prbstr/peak/docs/architecture.md

# Architecture, in full

`CLAUDE.md` has the short version. This file keeps the exact behaviour: thresholds, timings and the order in which the
eyes' reflexes win. Change it when the behaviour changes.

```
Pi (mech)                         Mac (mind)
 servod.py  <-- peak/mech/cmd --  orchestrator  <-- Ollama (brain)
 servod.py  -- peak/mech/sense -> orchestrator
 audiod.sh  -- UDP :5001 PCM ---> senses/hearing.js (whisper) -- peak/mech/event -> orchestrator
 camd.sh    -- UDP :5000 H264 --> senses/vision.js (Ollama vision) -- peak/mech/event ->
 servod.py  -- peak/mech/sense -> senses/presence.js (PIR, distance) -- peak/mech/event ->
 OLED       <-- servod.py draws two eyes (eyes.py, a port of RoboEyes) and moves them by reflex (screen.py)
                                  voice/homepod.py -- AirPlay --> HomePod mini (speaks every {"say"} on peak/+/cmd)
```

- One Mosquitto broker on the Mac (brew service, `*:1883`, anonymous). Bodies are clients only.
- Topics: `peak/<node>/cmd`, `peak/<node>/sense`, `peak/<node>/event`, `peak/<node>/status` (retained online/offline, set by Last Will), `peak/brain/intent`. Schemas in `contracts/`.
- Senses publish **events only**, never raw frames or audio. The orchestrator thinks on events.
- The brain never moves servos or eyes directly. It replies with `{gesture, say}` JSON (enforced with Ollama structured outputs); gestures are named in `node/gestures.yaml`. **With `PEAK_BRAIN_EYES=1` in `mind/.env` the shape is `{gesture, eyes, say}`**, where `eyes` is the name of a trick from `mind/tricks/tricks.yaml` or null. The orchestrator plays the trick after the reply is parsed, on its own time; the reply's own gesture and line win over the trick's, and on a `sensed` event a trick's gesture is dropped. This is **off by default** (5 Nov 2026): the eyes prompt missed the bake-off gate twice by one old case (see the Brain row in Status). Without the switch the prompt and schema are byte for byte what they were before tricks (checked).
- The brain answers in a JSON shape (`{gesture, say}`, or `{gesture, eyes, say}` with the eyes switch; gesture first so it can fire early) enforced with Ollama structured outputs, built in `mind/orchestrator/brain.js`. The models do carry the `tools` capability (an earlier note said otherwise); native tool calling for `look_at` is a follow-up, not a blocker.
- The orchestrator thinks on one event at a time; one more may wait, and a newer event replaces it (latest wins, never a backlog). Bodies that go offline are removed from the hive map.
- `servod` runs one motion at a time with a one-deep queue (newer replaces waiting). `say` runs independently of motion. `{"stop": true}` aborts the current move and releases all servos. On boot it eases servos to rest one at a time (`BOOT_SETTLE_MS`) to avoid inrush.
- `servod` also owns the GPIO sensors listed under `sensors:` in `node/config.yaml` (HC-SR04+ ultrasonic, PIR) and adds `distance_cm`, `motion` and `throttled` to `peak/<node>/sense` every second. `PEAK_SIM=1` simulates the servos only: sensors are real whenever the pins exist, so a body with no PCA9685 wired still senses. Readings go out twice a second and fill the hive map. They are not events: `mind/senses/presence.js` turns them into `{"sensed": "..."}` events on the two moments worth a thought, movement after a quiet minute and something coming close in front (thresholds and the reasons for them are in `presenceFilter.js`). The brain answers a sensed event with one line and no gesture, so no arm swings at something 5 cm away.
- `servod` draws the OLED (`display:` in `node/config.yaml`): two eyes filling the panel, no text and no numbers. `node/eyes.py` is a Python port of FluxGarage RoboEyes (rounded-rectangle eyes with moods, nine positions, blinking, wandering, laughing, confusion, sweat); `node/screen.py` decides what they do from what the body itself knows, with no help from the mind; `node/oled.py` packs the picture and sends only the bytes that changed. One thread in `servod` does all the drawing; the MQTT thread and the sense loop only report what happened and wake it. Like the sensors, the display is real under `PEAK_SIM=1`, and a missing display never stops `servod`.
- Dead-man switch (`node/deadman.py`, 9 Nov): when the mind's retained `peak/mind/mind/status` turns `offline` (its Last Will, sent the moment its socket closes) or the body loses the broker, `servod` cancels the move in progress and the one waiting and the servos hold where they are; it does not release them, because a limp arm drops under gravity. One `[servod] deadman: hold (<why>)` line per hold. An unknown mind status counts as alive, nothing replays when the mind returns, and hand commands still run while it is down. There is no silence timer: the mind's commands are one-shot and one legal move lasts up to 5 s. `servod`'s MQTT keepalive is 5 s (`PEAK_KEEPALIVE_S`), so a silent Wi-Fi drop is noticed within about 10 s. Each queued move carries the number of cancels (stops and holds) made before it; the worker drops one a cancel has overtaken and clears the stop flag under the same lock, so a stop can no longer slip between taking a move and starting it.
- The eyes' reflexes, highest claim first: broker offline or the mind offline = shut (asleep); something coming closer than 30 cm = wide eyes for 1.5 s, once, until it backs off past 36 cm; `look_left` / `look_right` = eyes held to that side for 3 s (the body's left is the viewer's right, position `e`); a spoken line = eyes centred and pulsing in height for 0.07 s per character, starting `talk_delay_s` after the command (2.5 s, the HomePod's lag); strain = tired lids from damage level 2 and one sweat drop more per level, where the level counts undervoltage now, CPU throttled now, undervoltage since boot, and 70 °C or hotter (`0x50005` is level 3: tired, two drops); otherwise they wander and blink. `strain: false` in `config.yaml` switches the strain look off.
- The mind can take the eyes over with an `eyes` command on `peak/<node>/cmd` (`contracts/cmd.schema.json`, `$defs.eyes`): `mood` (default, tired, angry, happy), `look` (center or a compass point, screen terms), `anim` (blink, wink_left, wink_right, confused, laugh; winks name the body's own eyes), `open`, `curious`, `shape`, and `ms` (100-60000, default 4000). A command with any state in it replaces the one before; `anim` alone leaves it in place. When `ms` runs out, or on `{"eyes":{"release":true}}` or `{"stop":true}`, the reflexes have the eyes back, so a mind that dies never leaves them stuck. Asleep and startled still win over the mind. The mood the mind sends replaces the tired look only while it holds; sweat keeps falling. Anything the body does not understand is ignored, never an error.
- **Tricks** are named sequences the hive can play on a body, kept as data on the mind in `mind/tricks/tricks.yaml`: steps of `eyes`, `gesture`, `say` and `wait`, plus a `describe` line for the brain. `mind/orchestrator/tricks.js` checks every trick against the body's command contract and `gestures.yaml` (at most 16 steps and 30 s), and `createTrickPlayer` sends the steps over MQTT; a newer trick or a stop takes the body from the one playing. First set: happy, angry, sleepy, confused, laugh, surprised, wink, peekaboo. A second file, `mind/tricks/learned.yaml`, is merged in at load through the same check (a bad entry is skipped with a warning, a built-in wins a name clash) and `appendTrick()` writes to it: nothing calls that yet. It is the door for teaching by voice and for Lupin.
- **Devices** (7 Nov 2026) are things in the room the hive can switch: nodes on the same broker with no senses and no gestures, the desk light first, a projector and its screen later. Each is data in `mind/devices/devices.yaml`: a `describe` line for the brain, the topic prefix its own firmware uses (`base`), the topic under it whose retained payload says online or offline (`status`, set by the firmware's Last Will), and its `actions`, each with a `describe` line, a topic under the base and the exact payload (a string, or an object sent as JSON). `mind/orchestrator/devices.js` checks the file at load (names are 2 to 24 of `a-z0-9_`, share one namespace with gestures and tricks, topics carry no wildcards, payloads at most 512 characters; a bad entry stops the mind, like a bad built-in trick) and `createDeviceHub` subscribes to the status topics, tracks which devices are online, and publishes an action's payload on its topic. Three things reach it: the brain's `action` field (**with `PEAK_BRAIN_DEVICES=1`** the reply shape gains `action` after `eyes` and before `say`, naming an action or null, with a Devices section, three rules and three examples in the prompt; off by default, like the eyes, until the bake-off says the old groups hold), a trick's `action` step (`tricks.js` checks it against the action names; the player runs it through the hub), and `npm run device -- <action>` by hand. An action is sent whether or not the device is online, with a log line when it is not. The desk light's firmware (lightbar2mqtt, `devices/desk-light/`) takes absolute levels only, so its six actions are presets: on, off, bright (15), dim (3), warm (370 mireds), cool (153).
- `peak-servod.service` reaches the Mac by mDNS name (`twentyones-Mac-mini.local`), not a fixed IP.
