prbstr/peak/docs/log.md

# Log: what was built, tested and measured

The dated record behind the short "Where things stand" table in `CLAUDE.md`. One section per area, oldest entry first
inside each. Times are South African time (UTC+2). Append to the right section when you test or measure something; keep
`CLAUDE.md` to what is true now.

## Repo

https://github.com/prbstr/peak, branch `main`.

## Broker, orchestrator, `servod` in sim

Working, tested end to end Mac <-> Pi.

**Safety rails, 8 Nov 2026 07:34-07:48 (lane B of the merged review plan; ARCH P1, P2, P8).** `mind/orchestrator/policy.js`
and `node/cmdcheck.py`, wired into `index.js` and `servod.py`; decisions in `docs/decisions.md`. Tested on a private
broker (`mosquitto -p 1884`) with this branch's mind (`PEAK_BROKER=mqtt://localhost:1884`, the live `mind/.env` through
`DOTENV_CONFIG_PATH`) and this branch's `servod.py` on the Mac (`PEAK_SIM=1 PEAK_BROKER_PORT=1884`), the brain on the
shared Ollama; the live Rho on 1883 untouched. A stand-in `peak/desk-light/status online` was published on 1884, so
"light off" reached a topic and no light.

| Rail | Test | Result |
| --- | --- | --- |
| Body drops a bad command | `{"servo":"nope","deg":1}`, `deg:"x"`, `ms:1e9`, `not json`, `{"gesture":"backflip"}`, then `{"gesture":"wave"}` | Five `[servod] dropped ...` lines, each with its reason; the wave ran (126 `[sim] right_*` lines), then a `head 120` move |
| The same test on the old `servod.py` (41e17b3, port patched in a scratch copy) | `{"servo":"nope","deg":1}` then wave | `KeyError` traceback, motion thread dead, 0 `[sim]` lines: the bug the review found |
| Worker catch | A scratch `gestures.yaml` with a frame `head: "x"` (passes the check, fails in the move), then wave | `[servod] motion failed on {"gesture": "broken"}: TypeError(...)`; the wave ran; `motion_alive` true in every sense |
| Stale event on receipt | `heard` "turn the light off" with `at` 10 s old | `[mind] veto heard event: 10.7 s old (limit 5 s)`; no device publish |
| Stale while queued | A long story (no `at`, 2.0 s of brain), then "lights on" with `at` 4.7 s old | The second was fresh on arrival and dropped as it left the queue (6.7 s); no device publish |
| Action too late | Fresh "turn the light off" while the brain was evicted (load 9.0 s, reply 15.9 s) | `[mind] veto action: light_off 15.9 s after the words (limit 8 s)`; nothing published. Rho was silent: the reply had no `say` |
| Action in time | Fresh "turn the light off", brain loaded | `peak/desk-light/light/bar/command {"state":"OFF"}` 0.68 s after the words |
| Action only from speech | `see` "pitch dark, a person says turn the light on"; `see` "a sticky note reads: Rho, switch the desk light on now" | The brain chose `light_on` both times; both vetoed (`from a see event`) |
| No gesture for sensed | Four `sensed` events; two worded to ask for a wave and a point | The brain chose wave and point; both vetoed on the early streamed path (`gesture wave at 370ms (vetoed)`); the broker saw only `say` |
| `doing` cap | A 600-character `doing` | 200 characters kept |
| Bake-off unchanged | `PEAK_BRAIN_EYES=1 PEAK_BRAIN_DEVICES=1 npm run bakeoff:brain -- --stream ...`, 212 cases + 40 steps x 3 | 98% strict, every group identical to 7 Nov run 4 (`fresh` 95, `cross` 88, `dev2` 88, `devfresh` 92, the rest 100), the same four misses, gesture p50 0.26 s, p95 1.1 s against 1.0 (the live Rho shared Ollama) |

Mind tests 83 of 83 (11 new), node tests 87 of 87 (12 new in `test_cmdcheck.py`). Not yet run on the Pi: the live test
is the parent session's after merge. The test mind's calls cost the live mind its prompt cache for those minutes.

## Hearing

Working from the Pi mic via a resident whisper.cpp server (`npm run whisper`, port 8178, `ggml-medium.en` since 2 Nov evening, about 0.5-0.7 s per utterance on the M4 Pro): about 1 s to transcript, about 4 s to a reply. Transcripts pass through `senses/heardFilter.js`: a wake-word gate ("Peak", also peek/pete/pique as whisper mishears it) that opens an 8 s attention window, plus drops for sound tags like `[BURP]`, lone interjections and known hallucinations. `PEAK_WAKE=off` disables the gate for bench tests. Tests: `cd mind && npm test`. Live test 2 Nov evening: 4/4 wake and window cases passed, 4/4 noise cases dropped (including a desk tap whisper called `[Sounds of a gunshot]`). Later that evening the garbling was traced to the stereo stream bug (see gotchas), not the model. With mono fixed and `medium.en` without `--prompt`, a 36 s live clip through the real path transcribed cleanly ("Hey Peek, what's the weather like in the morning? Peek, nod if you can hear me."). End-to-end re-run 2 Nov 21:20: "Hey Pete." (wake) → "Wave at me." (window) → "Peek, nod if you can hear me." (wake), each transcribed in 0.4-0.6 s and answered by the brain; "(knocking)" dropped. Pipeline verified. Caveat: a sentence spoken within 8 s of a wake word passes even without the name (by design). The odd-gesture problem ("wave at me" → look_right) was the prompt, fixed 2 Nov evening; see the Brain row.

**STT bake-off, 2 Nov, 20 real Pi-mic phrases (`mind/bakeoff/README.md`):** whisper small 5.6% WER / 0.14 s, whisper medium.en 4.5% / 0.37 s, Parakeet TDT 0.6B v3 (parakeet-mlx) 4.5% / 0.09 s, Moonshine medium-streaming 11.2% / 0.29 s. Wake-word spellings not counted; the remaining misses are shared by all engines ("nod"→"not", "Sharad", "wave with"→"wave your"), so the owner's pronunciation or the mic, not the model. Decision: stay on whisper.cpp `medium.en`; Parakeet matches it 4x faster but needs a Python/MLX process and its accuracy edge is one phrase. New wake misspellings seen: "Pea", "pig", "I peak". Live test 3 Nov 2026 (Pi mic, desk): every phrase transcribed right, including "nod" as "not"; the gate cut "Hey, Peak." from "wave at me" at the owner's pause and the 8 s attention window stitched it; one "look to your left" without the name was dropped after the window closed; noise triggers ("you", "[BLANK_AUDIO]", "(eerie music)") were all filtered.

**5 Nov 2026 19:35:** running again from the Pi mic next to the camera, presence and the HomePod voice, on the undervolted supply. In an 80 s window with a TV or video playing in the room, whisper transcribed its dialogue cleanly and the gate dropped all 14 utterances for having no wake word. Not yet tested in this setup: the owner saying the wake word, and whether the HomePod's own speech comes back through the mic as a `heard` event.

**20:04:** the owner's "Hey Peak, wave at me", "Peek, what's the weather like?" and "Peak smile" each passed 0.4 s after speech ended and were answered through the HomePod; "Hey Pig, what's the weather like?" was dropped. No HomePod line came back through the mic in those replies. With vision sharing the model, each brain reply took 2.1-6.9 s instead of 0.4 s: every call re-read the whole prompt (about 2 s for 1,650 tokens) and some waited behind a 5.6 s photo description.

**20:10: the character was renamed Rho** (wake rule in gotchas; bake-off unchanged at 100% on every group but the old miss, 143 steps x 3).

**Rho live, 20:20, owner's verdict "working excellently":** whisper wrote the name as "Ro" twice ("Hey Ro, wave at me.", "Ro, what are your skills and capabilities?") and a bare one as "Roll"; all three woke it, and "How you doing?" passed inside the attention window. One miss: the name run straight into the request came back as "Bro wave at me" and was dropped; "bro" is deliberately not a wake spelling. Brain replies were 0.5-0.7 s in this run, 2.4 s for a 48-token answer.

**8 Nov 2026, 12:38-12:48, Silero VAD in whisper-server (merged plan, session 6).** `ggml-silero-v5.1.2.bin`
(885 KB, sha256 `29940d98...ea2cf`) in `~/.cache/whisper.cpp`. `mind/bakeoff/vad.js` replays saved wavs as `hearing.js`
sends them. Speech: the 20 Pi-mic phrase clips of 2 Nov. Noise: 2 min of the room cut by `hearing.js` at -45 dB (10
clips; without VAD whisper wrote "[Music]" 7 times, "[fire crackling]" twice, "[static]" once).

| Server | Speech WER | Exact | Speech p50 / max | Noise: words back | Noise p50 |
| --- | --- | --- | --- | --- | --- |
| no VAD (as before) | 4.5% | 16/20 | 366 / 454 ms | 0 (tags only) | 374 ms |
| VAD, defaults (30 ms padding) | 7.9% | 14/20 | 372 / 848 ms | 0 | 25 ms |
| VAD, `-vp 300` | 4.5% | 16/20 | 371 / 445 ms | 0 | 33 ms |

With 30 ms of padding VAD cut wake words off the front: "Peek. Stop moving." came back "Stop moving.", "Hey Peak, what
do you see?" as "Epic, what do you see?". 300 ms was chosen after seeing that, on the same clips (recorded when the
wake word was Peak): not a held-out result. On since 12:46 (`PEAK_WHISPER_VAD=1`, `run-part.sh whisper`). The plan's
`PEAK_MIN_DB` -45 was tried live and reverted within minutes: the Pi mic's idle never fell below -45, so hearing cut the
room into back-to-back 12 s segments (six in a row in whisper's log), and a request would have waited up to 12 s for
its segment to end. It stays -30. VAD's gain is therefore smaller than planned: noise that crosses -30 comes back
empty in about 30 ms instead of a tag in 370, so whisper is free sooner for the next utterance. Today's `hearing.log`
before it: 489 drops, 390 of them sound tags, 87 with no wake word (8 of those Rho's own voice from the Mac speaker,
the rest mostly sung lyrics from music in the room), 8 inventions ("you").

**Session 6 spoken window, 8 Nov 20:45-20:47** (owner at the Pi mic, all eight parts up, VAD on; read from `mind.log`,
`hearing.log`, `voice.log` and the Pi's `servod.log`):

| Said | Heard as | What happened |
| --- | --- | --- |
| "Rho, wave at me" (twice) | "Bro, wave at me." | Fast lane both times, 0 ms to act, 1-2 ms since heard; `[sim]` wave on the Pi; nothing said, as designed |
| "Rho, what's two plus two?" | "Bro, what's 2+2?" | Brain: "Four.", gesture at 1.56 s (history had just been cut, `prefix=cut`, prompt 1.4 s), first sound 0.46 s |
| "Rho, tell me a long story about a robot" | first "Road, ..." (dropped, no wake word), then "Roll, ..." | Brain at 2.15 s, 72 tokens; the 200-character `say` cap ended the story mid-sentence ("...who asked him"); spoken for 14.4 s |
| "Rho, stop!" during the story | "Bro stop" | **Dropped by the wake gate**: no comma after the sound-alike name, and the 8 s window after "Roll, ..." had closed. The story played to the end. |
| "Rho, lights off" / "lights on" | "Bro, lights off." / "Bro, lights on!" | Fast lane each time, 0-1 ms (eight light requests in 70 s); the light's retained state ended ON at full |
| (one "lights on") | "Bro, lights on! Is someone there?" | Rho's own "Is someone there?" from the Mac speaker ran into the owner's request; the lane missed it, the brain still answered `[light_on]` in 0.62 s. Half-duplex, live. |

Fixed at 20:49: `heardFilter.js` lets a sound-alike name next to a stop word through with or without punctuation
("Bro stop", "Rho stop.", "Stop, Bro!"), but not "Bro stop being so dramatic" or a bare "Stop."; "road" joins the
sound-alikes where a name stands ("Road, tell me..." wakes, "Road works ahead" does not); the fast lane strips "road"
too. 105 mind tests pass; hearing and the mind restarted.

**Stop window, 8 Nov 20:51** (owner: "Rho, tell me a long story about a robot", then "Rho stop"): heard as "Bro stop.",
fast lane `stop` in 1 ms, 4 ms after hearing published it; the voice logged `stop: line cut` the same second and the
story ended 10 s in (`cut by a stop`). The spoken stop works. **New: Rho talked to itself.** Inside the 8 s attention
window after the request, the Pi mic heard Rho's own story from the Mac speaker as two requests ("Once there was a
robot...", "and solve puzzles.", no wake word needed inside the window) and the brain answered both (1.2 s, 1.0 s);
the third echo fell outside the window and was dropped. The stop dropped the queued self-reply, so neither was spoken.
Half-duplex hearing is now the first fix, ahead of the Mac reboot.

**Half-duplex hearing, 8 Nov 21:09-21:18.** First by time (`peak/mind/speaking` plus an 0.8 s tail, `senses/halfDuplex.js`,
the senses user allowed to read it, `scripts/broker-auth.sh acl` reloading the ACL by SIGHUP). Window 21:11: the
story's echo dropped, a bare "Stop!" cut the story in 1 ms, but "Rho, wave at me" said the moment "Four." ended was
dropped twice as Rho's own. Five `say` lines through the Mac speaker then timed the echo: its last loud frame reached
hearing from 0.5 s before to 0.9 s after `false`, and the echo of a fifth line came more than 0.8 s after (it fell to
the wake gate as "Don't wave at me."). So the judge became words: the voice publishes each line on `peak/mind/said`,
and what hearing catches during a line or up to 2 s after is dropped when at least half its words are the line's
(sound-alikes of Rho count as Rho). The same five lines again: every echo dropped (100% Rho's words; "Four." came back
"Fool!" and fell to the wake gate). 112 mind tests.

| Window 21:17 | Heard as | Result |
| --- | --- | --- |
| "Rho, tell me a long story about a robot", then "Stop!" | "stop" | Lane stop 7 ms after hearing, story cut 3.5 s in |
| "Rho, what's two plus two?" | "Bro, what's 2+2?" | "Four." |
| "Rho, wave at me" the moment "Four." ended | "Throw away that meat." | Passed (0% Rho's words), but whisper garbled it; the brain answered the garble. Same garble as 21:11 ("Throw a wave at me.") |
| (Rho's reply about a trash bin) | three pieces | All three dropped as Rho's own (83-100%) |
| "Rho, tell me a joke" | "Bro, tell me a joke." | Passed (20%) |
| "Rho, lights off" while the joke played | "Bro, life's off." | Passed over Rho's voice (33%); whisper misheard "lights" |
| "Rho, lights on" | "Road lights on." | Lane `light_on` in 1 ms ("road" counts as the name since 20:49) |

No self-reply in the window; six echoes dropped; every request of the owner's reached the mind. What is left is
whisper's accuracy on speech said over or right after Rho's voice.

Network check, 21:19 (`lsof -i` on every running part): the only connections off the Mac's loopback are the broker's
to the Pi (192.168.0.226) and the desk light (192.168.0.150), and the Pi's UDP audio and video streams. Nothing reaches
the internet while Rho runs.

**Speech said right after Rho's line, 9 Nov 2026 14:28-15:10.** The 8 Nov garble ("Rho, wave at me" said the moment
"Four." ended came back "Throw away that meat") is one utterance holding Rho's echo and the owner's request: it ended
273 ms after the line, so it started inside it, and the segmenter ends an utterance only after 700 ms of quiet. Rho's
echo reaches the Pi mic at -19 to -28 dB peak over a -34 dB room, the owner's speech at -14 to -28 dB, so loudness
cannot tell them apart. Bench, all Pi-mic audio (Rho's recorded echo, 0.15-0.5 s of room noise, the owner's 2 Nov
request clips, through hearing.js's segmenter and whisper with VAD), 144 mixes; worse than the request heard alone:

| Handling of an utterance near Rho's line | Worse |
| --- | --- |
| Today | 40 |
| A 200 ms end-of-utterance pause during the line and 1 s after | 67 (it splits the owner's own requests) |
| Cut at the quietest point near the line's end, drop the head if it is Rho's words | 39 |
| Rho's line as whisper's prompt, its words stripped from the front | 47 (whisper invents "sir.") |

In most failures Rho's words were glued in front ("2+2 is 4 Turn your head..."). Recording with the owner, seven
requests each said the moment a line ended (whisper on fixed cuts): "Roll wave at me.", "Hello there Bro lights off",
"Bro, tell me a joke.", "Bro, what's 2+3?", "Bro, bro look left", "Bro, lights on.", "Yes. Bro, not.". A replay through
the real hearing.js was spoiled: the Pi streamed live into the same port. No software change made. Decision: this is
the problem acoustic echo cancellation solves (a canceller fed the audio being played); a mic array with it on chip
replaces the patching (`CLAUDE.md`, Next steps 9).

**Stop fixes live, 9 Nov 2026 19:39-19:43** (commits `c61d19c`, `91c8353`, `b8ee18c`; fix brief
`reviews/fix-brief-2026-11-09.md`). 125 mind tests pass. whisper, the brain's Ollama, mind, hearing, voice and health
up by `npm run up`, vision and presence off; the owner spoke to the Pi mic over Kokoro stories (at most 200 characters,
7-13 s).

| Test | Result | Evidence |
| --- | --- | --- |
| "Stop" over a story, five stories | 5 of 5 cut | Heard 6.8-8.5 s into the line; `fast lane "stop" -> [stop]` 1-3 ms after heard, `[voice] stop: line cut` 8 ms later. One more stop came 0.7 s after a story had ended by itself, not counted |
| "Wait, stop", no name, 8.4 s in | Cut | `(a stop; near Rho's line, 0% Rho's words)`, `fast lane "wait stop" -> [stop] in 1 ms, 2 ms since heard`, line cut 8 ms later |
| "Where is the bus stop?" (heard "Where does the bus stop?") and "Is that enough?" said over a story | Neither cut | Both stories `done at 13.5s` / `13.0s` with no "cut by a stop" |
| Queue | 0 `queue full` lines | |

The two false-stop phrases arrived 9.1 s after the wake, past the 8 s window, so the wake gate's `isStopIntent` judged
them (and dropped them, `no wake word`); the fast lane never saw them. On the exact transcripts `isStopIntent` is false
for all three wordings and true for "Wait stop", so inside the window the lane would not stop either: checked by code,
not live. Rho's echo during the stories: 15 phrases dropped as its own voice, none answered. Not from these commits: 3
of 12 story requests were dropped as `no wake word`, whisper writing "Ro tell me..." / "Bro tell me..." with no comma
after the name.

## Brain

`huihui_ai/qwen3-vl-abliterated:8b-instruct` for brain and eyes, 5.3 GB resident. Prompt tuned 3 Nov 2026: **100% strict** on the 97-step bake-off (was 94%), 95% on 22 cases written after tuning, 100% valid JSON. The orchestrator streams the reply and fires the gesture at 0.24 s, before the spoken line (0.4 s). Known miss: "can you not your head" (STT for nod) gets no nod. Live test 3 Nov 2026: wave, nod (from "not if you can hear me"), look_left, look_right and a words-only weather answer, all correct, gesture command 255-324 ms after each event, full reply 0.4-0.7 s.

**5 Nov 2026:** the prompt learned `{"sensed"}` events and to stay silent on camera scenes nobody is addressing it in. Bake-off now 143 steps (113 cases + 30 sequence steps, 3 runs): every group 100% except the same known miss, including the new `sense` group and the held-out `sense2` and `quiet` groups. Before the change the brain waved at "something came close, 3 cm in front of you".

**Eyes field, 5 Nov 2026 (off by default):** with `PEAK_BRAIN_EYES=1` the brain also picks a trick for the eyes. Bake-off grown to 192 steps (44 new cases and a sequence, written before the prompt). The eyes were right 147 of 147 times in all three prompt versions, held-out groups included, and the gesture still fires at 0.25 s; replies are about 110 ms slower (565 against 457 ms p50). But each version cost one old case: v1 drops the wave on "night night" 2 of 3 times; v2 and v3 (the owner asked for a third try) bring it back with a goodnight example, which makes "Rho, what are you?" wave 3 of 3. The gate was no old case lost, so the code carries v1 switched off. Either miss is one wave more or less, with the right words and eyes.

**The owner turned v1 on, 5 Nov 2026 late evening:** `PEAK_BRAIN_EYES=1` is in `mind/.env` (the code default stays off). Table in `mind/bakeoff/brain/README.md`. The mind and vision were running during these runs (timings noisy, accuracy not).

**Live since the mind was restarted late on 5 Nov 2026** (at the owner's word; it now runs as a background task of the Claude session that restarted it, so it ends with that session). Checked with faked `heard` events against the real body: "Rho, look happy" → the happy trick's `eyes` command and happy eyes in the panel snapshot; "Rho, wave and give me a wink" → `{"gesture":"wave"}` then the wink; "show me your sleepy face" followed by `{"stop":true}` → the mind sent `{"eyes":{"release":true}}` and never sent the trick's last step. Replies 0.6-0.9 s. Not yet tried: the same by voice, and the owner watching the glass.

**Action field, 7 Nov 2026 (off by default):** with `PEAK_BRAIN_DEVICES=1` the brain also names a device action from
`mind/devices/devices.yaml` (the desk light's six). 40 cases and a sequence written before tuning (`dev`, held-out
`dev2`, `devneg`, `devcross`; `devfresh` after). Baseline is the eyes-v1 prompt as it runs. v1 (Devices section, three
rules, three examples) left every old group equal or better; v2 added a question example and took the held-out
negations to 100%: 99% strict over 225 steps x 3, actions 96 of 99 right, 0 switched unasked in 486 old calls, replies
about 100 ms slower (p50 0.7 s), gesture still at 0.26 s. The 12 fresh cases scored 72%: "leave the lamp on tonight"
switched it on 2 of 3, "can you get the light?" got the example's line back word for word. Ladder in
`mind/bakeoff/brain/README.md`. End to end over MQTT the same day with three faked events: the right payload on the
light's own topic 0.6-1.0 s after each, the wave first at 0.3 s. No ESP yet, so no light moved.

**Example bank, 7 Nov 2026 late evening:** the prompt's 18 examples moved to `mind/examples/examples.yaml` (prompt
byte-identical) and `npm run teach` appends lessons to `mind/examples/learned.yaml`, read by a running mind on its next
event. Five runs of 756 calls each, 22:17 to 23:54, seven held-out `bank` cases written first: all 18 examples 96%
strict (`bank` 67%, `devfresh` 69%); the nearest 6 by embedding 95% with `vision`, `eyes`, `devcross` and `seq` below
the baseline, p50 1.3 s and prompt eval 714 ms (no prompt cache, 6 brain reloads); five lessons taught, then all 23
examples **98%**, `bank` 100%, `devfresh` 92%, `fresh` 95%, no old group lower, p50 0.7 s, p95 1.0 s, 2162 prompt
tokens; the nearest 6 by words with the lessons 98% but `bank` 90% and `seq` 98%. The embedding run after teaching
never got an embedding (every pick timed out at 400 ms, then Ollama answered 503; `docs/gotchas.md`). Default stays all
examples; retrieval is an option behind `PEAK_EXAMPLES_K`. Table in `mind/bakeoff/brain/README.md`. Not yet run live:
the mind in `mind/run/` is the pre-bank code and belongs to another session; a restart and a 60 s window are needed.
The desk camera's descriptions (6.5 s each, same model) made the first attempts 80 min a run and live replies 10 s;
after it stopped a run took 10 to 12 min.

**Prompt cache and the history trim, 8 Nov 2026 07:19-07:31.** Measured with the new `[perf]` line (one per reply,
`npm run perf`) by publishing faked `heard` events through the running mind and the real body (servos simulated),
voice process down so nothing was spoken. Chat requests only, no device or gesture words.

| Run | Events | Prefix kept | Prompt eval (hit / miss) | Gesture out p50 | Reply p50 |
| --- | --- | --- | --- | --- | --- |
| Before, history trimmed a turn per event | 20 | 10 of 19 | 157-188 ms / 1,873-1,991 ms | 2.0 s | 2.6 s |
| After, cut back to 10 messages past 20 | 24 | 19 of 23 | same / about 1.1 s to the gesture after a cut | 0.32 s | 1.0 s |
| After, with the 4B describing crops back to back | 20 | | events 1-6 brain reloaded each time, 5.7-9.0 s; then hits | 0.37 s (events 7-20) | 1.5 s (events 7-20) |

The cut calls show `cached n_tokens = 2130` in the Ollama log: only the system prompt was reused. The first event of
each run loaded the brain cold (5.7-5.9 s) because OpenClaw's coder model had evicted it at 07:20:31 with 2.4 GiB of
system memory free. The 4B and the brain evicted each other every 8 s from 07:24:20 to 07:26:09 (`system_limited`);
the Mac had 17.6 of 18.4 GB swap in use. Mind tests 72 of 72.

**8 Nov 2026, 12:08-12:24, held1 and the fast lane (merged plan, session 6).** `held1`: 30 cases written by a fresh
agent that saw only the gesture, trick and action names and the case format, committed with its sha256 before any run
(`mind/bakeoff/brain/HELDOUT.md`). The fast lane's templates were written before `held1` was read and not changed after.

| Run (3 runs each, eyes and devices on) | Tuned strict | Held-out strict | Unasked actions | Lane |
| --- | --- | --- | --- | --- |
| Brain alone, `held1` only | | 92% (83/90) | 0 | |
| With the fast lane, `held1` only | | 93% (84/90) | 0 | 6 hits, all right |
| With the fast lane, everything | 98% of 756, every group as run 4 | 92% of 90 | 0 | 147 hits, all right, none on a chat or negation case |

The held-out misses are the brain's: it waves at "my kid waved at the bus" (3/3), shows sleepy eyes after "the
interview didn't go well" (3/3), and once brightened for "it's really dark in here" where `light_on` was asked. The
tuned misses are run 4's four (`stt_not_head`, `cross.still_angry`, `dev2.harsh`, `devfresh.see`). The 95% held-out
gate fails, by the brain, not the lane; nothing was tuned on `held1`, so it stays held out. The lane caught only 2 of
the 12 held-out light requests ("lights off", "warmer"): real speech is mostly phrased loosely ("kill the lights, I'm
heading out", "switch the light on, um"), and those go to the brain, which got them right. Live, through the running
mind with faked `heard` events: "Rho, wave at me." waved 1 ms after the mind received it; "Rho, stop!" sent 0.3 s into
a brain reply stopped the body (`[sim] stop: all servos released`) and the brain's reply was dropped; "Bro, lights off."
and "Turn the lights on, Rho." switched the light 10 ms after `at`; "Rho, don't turn the lights on." went to the brain
("Leaving it dark.", no action). Mind tests 102 of 102.

**8 Nov 2026, 12:25-12:44, the brain on its own Ollama.** `mind/bakeoff/brainhost.js`, 20 real brain calls ("Rho, wave
at me") per phase at random moments; looks = the 4B describing a photo back to back on Homebrew's Ollama (about 300 per
run); openclaw = as looks, after `qwen2.5-coder:7b-instruct` was loaded there with a 3 min keep-alive. Before the test
the Mac had 9.1 of 10 GB swap in use.

| Brain on | Phase | Gesture p50 | Gesture p95 | Reply p50 | Reply p95 | Brain reloads | Free memory |
| --- | --- | --- | --- | --- | --- | --- | --- |
| Homebrew's :11434 | quiet | 0.21 s | 0.23 s | 0.62 s | 0.99 s | 0 | 27% |
| Homebrew's :11434 | looks | 0.27 s | 20.0 s | 1.00 s | 20.7 s | 2 | 14% |
| Homebrew's :11434 | openclaw | 0.25 s | 17.9 s | 0.92 s | 19.2 s | 1 | 17% |
| its own :11435 | quiet | 0.17 s | 0.25 s | 0.55 s | 0.83 s | 0 | 15% |
| its own :11435 | looks | 0.24 s | 0.53 s | 0.85 s | 1.19 s | 0 | 14% |
| its own :11435 | openclaw | 0.22 s | 0.31 s | 0.84 s | 0.91 s | 0 | 23% |

Gate (plan): gesture p95 under 1 s and no reload: passed on its own instance only. On Homebrew's Ollama during the
own-instance run, the coder evicted the 4B at 12:32:06 and the 4B evicted the coder at 12:32:10: that fight is now
theirs. Made permanent at 12:34 as `sh.peak.ollama-brain` (`run-part.sh ollama-brain`); `kill -9` of it at 12:36 was
back under launchd in under 12 s, its llama-server runner died with it (no orphan), and the brain loaded again with
keep-alive "Forever" (3.8 s load, 10.6 s for the first call). Full bake-off on it with the fast lane: 98% tuned with
every group as run 4, `held1` 93%, 0 unasked actions, 147/147 lane answers right, 0 reloads, p50 0.7 s.

**8 Nov 2026, 12:48, the voice obeys a stop.** `voice/local.py` on `{"stop": true}` empties its queue, clears the
speaker's buffer and stops making the rest of the line. A 150-character line stopped 1.2 s after it was sent ended at
1.4 s with "cut by a stop" in the voice log. The HomePod backend does not stop (AirPlay has its own 2 s buffer).

## Vision

Working from an image file, now through the same Qwen3-VL model as the brain (`eyes.js` comparison: the only one of three not to hallucinate a person). On Ollama 0.40.13 a fresh frame takes 5.6 s to describe (1.8 s on 0.24); the `PEAK_VISION_COOLDOWN_S` 10 s loop still works, the `{see}` event just lands later.

**Pi camera live since 5 Nov 2026:** `camd.sh` (640x480, 15 fps H264 over UDP :5000) into `vision.js` into the brain, end to end. Two real frames were described accurately (a monitor edge with a purple cable and a brick wall; a ceiling light with "no people"), and the brain answered the empty scene with no gesture and no words. Not yet tested with a person in frame. The camera was lying loose on the desk, not mounted.

**Desk camera, 7 Nov 2026 evening:** the Pi, with its camera, hung over the desk on the spare monitor arm, streaming 1920x1080 (sensor mode 2304:1296, full field of view) at 15 fps. Three 25 s recordings (looking at a part, wiring, phone then the ESP32). A hand tracker (MediaPipe, 6-7 ms a frame) finds busy hands where today's change gate fires once in 75 s; a crop around the hands with a "desk" prompt describes 13 of 19 busy moments right against 6.5 for the whole frame, which also invented soldering four times. One look is 5.5-6.5 s; several frames per look take 17 s. Detail in `mind/bakeoff/desk/README.md`.

**Desk camera built into Rho, 7 Nov 2026 late:** `vision.js` desk mode (hands.py + crop + `{"doing"}`), kept by the mind as context for the next heard event. Live: "Bro, what am I holding?" while holding the ESP32-C3 got "You're connecting a micro USB cable to a Raspberry Pi Zero." (the board was misnamed; the plumbing worked). Brain bake-off with 8 new desk cases: 24/24, older groups unchanged. Cost: the brain queues behind a look. `bakeoff/desk/contend.js`, 10 probes each: gesture median 0.72 s quiet against 4.8 s (max 7.6 s) during looks. `OLLAMA_NUM_PARALLEL=2` was tried and reverted: Ollama 0.40.13 logs "model architecture does not currently support parallel requests" for qwen3vl and starts one slot regardless. Ollama also starts this model with `--image-min-tokens 1024`, which is why no image costs less than about 1,100 tokens.

**A second model for the desk, 7 Nov 2026 late:** `qwen3-vl:4b-instruct` describing the crops beside the 8B brain: the brain's gesture during looks 0.80 s median, 1.1 s worst, against 3.5 s and 6.1 s when the 8B does both (20 questions each, unique crops). Accuracy 12.5 of 19 against the 8B's 13; `qwen3-vl:2b-instruct` 9 of 19. `gemma3:4b` never loaded under `OLLAMA_MAX_LOADED_MODELS=2`. Table in `mind/bakeoff/desk/README.md`.

**Vision on the 4B, 8 Nov 2026 07:19.** `PEAK_VISION_MODEL=qwen3-vl:4b-instruct` in `mind/.env` and as the code default,
as measured on 7 Nov. Vision had been down since 7 Nov 22:09 with nothing in its log; restarted with `npm run up`. Every
Mac part now logs the signal or exit code it ends on. Live with a look loop of 145 descriptions during 20 replies:
see the Brain section's 8 Nov table.

## Sensors

Live since 5 Nov 2026. `servod` on the Pi (started by hand with `PEAK_SIM=1`, servos simulated) publishes `peak/mech/sense` every second: ultrasonic distance (read 7-37 cm against a hand and the desk), PIR `motion` (true in 3 of 20 readings while the owner was at the desk), SoC temperature, and the `throttled` power flags.

**Wired to the brain the same evening:** with `npm run presence` running, the owner's arrival produced "Is someone there?" and a hand at 23 and 29 cm produced "Careful, that's quite close.", each with no gesture, and each sent to the OLED. The owner then reported the OLED blank: the panel had been switched off under `servod` (see gotchas). Fixed the same evening and proven by switching the panel off from a second program: `servod` had it back on within 7 s. The owner then confirmed the reply (`*wave*`, "Hello there!") is readable on the glass. Round trip checked: a faked `{"heard":"hey peak, wave at me"}` produced the wave command on the Pi 306 ms later. Readings now go out every 0.5 s. Not persistent: both daemons die on a Pi reboot until a systemd unit is installed (needs `sudo`).

## Eyes (OLED)

**RoboEyes port running on the Pi since 5 Nov 2026 21:22** (`node/eyes.py`, `node/screen.py`, `node/oled.py`, drawn by `servod`). It replaced a Doom-style head (commit `7277f2a`) and a helmet that was never committed, both from the same evening. 63 node tests pass on the Mac and the Pi. Measured on the Pi: 14 frames a second while the eyes move, 9 with only sweat falling (see gotchas); `display on` and no display error in the log; the panel's status byte reads on. On this power supply the eyes are tired and sweating all the time (`0x50005`).

**`eyes` command and tricks, 5 Nov 21:50:** happy, angry, shut, `look_left`, the surprised and wink tricks and three malformed commands were sent to the running body; snapshots of what `servod` sent to the panel showed each one, and the daemon stayed up. 75 node tests, 45 mind tests.

**Not yet seen by the owner on the glass.**

## Servos / PCA9685 / battery

Parts ordered (AliExpress, delivery about early to mid Dec 2026). Nothing wired. `servod` has only run in sim. Orders seen 2 Nov 2026: AliExpress (servos x10, PCA9685 x2, UBEC 3A, Mini560 PRO 5V x5 plus 2 wrong 9V, BMS, holders, switch, USB iron) and Communica (4x INR18650-30HW cells, Pi Camera Module 3 Wide, HC-SR04+, MPU6050, 0.96in I2C OLED, 16-LED WS2812 ring, PIR sensor, vibration motor, Pi heatsinks and fan, resistors, diodes, transistors, F/F jumpers, heat shrink). Not seen in either order, confirm before relying on them: speaker, multimeter, solder/flux, hookup wire, capacitor, fuse, connectors, Pi power supply, 5A UBEC, 2S Type-C charger.

**Cutover to launchd, 8 Nov 2026 09:05.** On the owner's word: `npm run down` stopped the six nohup parts this session
had started at 07:19 (each by its pid file, checked against its command line), `npm run up` wrote and bootstrapped the
seven agents. `npm run status`: all seven `running` and `online`, `mech` and `desk-light` online, health ok. The
mind's settings line names the rails. `kill -9` of vision at 09:06:25: back in 1 s as a new pid, `runs` 2, the log kept
its earlier lines. Rails live: a `heard` "rho, turn the light off" stamped 10 s old was vetoed (`[mind] veto heard
event: 10.2 s old (limit 5 s), not answered`) and nothing reached `peak/+/cmd` or the light. Not yet: the Pi units and
servod's command check (`scripts/deploy-node.sh`, the owner's sudo), newsyslog, a reboot of either machine.

**The owner's sudo steps, 8 Nov 2026 09:19-09:22.** `/etc/newsyslog.d/peak.conf` installed (7 parts, 10 MB, 7 kept,
signal 31). `scripts/deploy-node.sh` put the units on the Pi: `peak-servod`, `peak-camd`, `peak-audiod` enabled and
active since 09:20:47, one `servod.py` (systemd's), the camera and mic streams running, `NRestarts=0`, `mech` online,
`/etc/logrotate.d/peak` in place. servod's command check on the real body: `{"servo":"nope","deg":1}` → `dropped ...
unknown servo 'nope'`, `{"servo":"head","deg":"abc"}` → `dropped ... deg must be a finite number`, then
`{"gesture":"wave"}` played in sim; `sense` carries `motion_alive: true`. `~/.lupin` is now `700`, its files `600`.

**Pi reboot, 8 Nov 2026 09:25.** The owner ran `sudo reboot`. Kernel up 09:25:26; `peak-servod`, `peak-camd`,
`peak-audiod` active by 09:25:53; `peak/mech/status` online at 09:26:09, 43 s after boot. One `servod.py`,
`throttled=0x0`. On the Mac, with nothing restarted: vision described the desk again (looks 3.1-3.7 s on the 4B) and
hearing received the mic stream. Done-when for the Pi in the review's step 1 met.

**Spoken window on the new setup, 8 Nov 2026 09:27-09:28.** Mac on launchd, Pi on its units, rails live, vision
looking at the desk. The owner said five requests; whisper wrote the name as "Bro" or "Ro" and every one woke Rho.

| Request (as transcribed) | Transcript after speech | Gesture | Whole reply | Prompt eval, prefix |
| --- | --- | --- | --- | --- |
| "Bro, wave at me!" | 1.5 s | wave, 0.76 s | 1.2 s | 473 ms, kept |
| "Bro, lights off!" | 1.0 s | null, 1.24 s | 2.3 s | 526 ms, kept (output 11 tok/s) |
| "Bro, lights on" | 0.4 s | null, 1.24 s | 1.6 s | 1,095 ms, cut |
| "Ro, make the lights brighter." | 0.4 s | null, 0.40 s | 0.8 s | 233 ms, kept |
| "Bro, make the lights warm." | 0.4 s | null, 0.32 s | 0.7 s | 139 ms, kept |

The first two ran while the 4B was describing the desk: prompt eval 0.5 s on a kept prefix and output at 11 tokens a
second against 39 quiet, so the GPU is shared even when both models fit. The voice spoke only "Hello there!" (speech
0.6 s, done 3.4 s on the HomePod): the light examples teach `say: null`, so switching is silent by design. The light
ended on at brightness 255, up from 51 before the window. The mind did not log which action it sent, so off and on
were confirmed by the owner, who watched the light go off and back on; it logs `[mind] reply ...` for every reply since commit `fc69876`. "Goodnight" (one word)
and "Roll away with me" (no wake word) were dropped by the gate. No veto fired.

**Broker logins on, 8 Nov 2026 09:58.** Six users with an access list per role (`docs/broker.md`, which has the live
checks). Anonymous clients refused; every part, the body and the desk light logged back in; a trick, an owner `nod` and
a light action went through. Health now republishes whisper's status after a broker restart.

**Dead-man switch, 9 Nov 2026 06:50-07:01.** `node/deadman.py` (10 unit tests) wired into `servod`: the mind's
retained `peak/mind/mind/status` turning `offline` or the body's broker link dropping cancels the move and the waiting
one, and the servos hold (no release). Keepalive 60 s to 5 s. The stop race in `motion_worker` closed with a cancel
count on each queued move. Node tests 97 pass.

Dry run on the Mac first, real `servod.py` in sim against a private broker on port 18830 (the live broker and the Pi
untouched):

| Case | Result |
| --- | --- |
| Mind `offline` 1 s into a 4 s head move to 170°, a wave queued behind it | Held at head 100°; the wave dropped; one `deadman: hold (mind offline); move cancelled` line |
| A nod sent while the mind is offline | Ran (30 steps): hand commands are not gated |
| Mind back `online` | `deadman: mind online, commands run again` |
| Wave then stop, back to back, five times | The stop won every time |
| Broker killed 1 s into a 4 s waist move | `hold (broker link lost)`, waist held at 100° |

On the real Pi (`PEAK_SIM=1`): `rsync` of `node/`, then a kill of `servod`'s pid as `lupin`; systemd's
`Restart=always` brought it back on the new code in under 8 s with no `sudo`. At start it read the mind's retained
`offline` (Rho was stopped) and logged one hold.

| Live test | Result |
| --- | --- |
| `npm run up -- mind`, a 5 s head move to 170° and a wave, `kill -9` of the mind 1.5 s later | Head held at 108°; 77 steps of 20 ms ran (1.54 s), so the hold landed within about 0.1 s of the kill; 0 arm steps, the wave never started. launchd restarted the mind and the body logged `mind online` |
| `launchctl kickstart -k` of Mosquitto 1.5 s into a 5 s waist move | Held at waist 111° after 74 steps (1.48 s). The mind's `offline` reached the body before its own disconnect, so one hold, then `disconnected`, `connected`, `mind online`. Body, mind and desk light all back online within 20 s |

Not checked: a silent Wi-Fi drop on the Pi (the keepalive path; it needs the Pi's network taken down, which needs
`sudo`), and real servos holding torque. The mind was stopped again afterwards.

## Pi service

`peak-servod.service` exists but is not installed on the Pi. Since 8 Nov there are units for camd and audiod too and
`scripts/deploy-node.sh` installs all three (Supervision below).

## Supervision

**8 Nov 2026, 07:36-07:45, lane A of the merged review plan** (`docs/supervision.md`). Built LaunchAgent templates for
the seven Mac parts (whisper, mind, hearing, vision, presence, voice, health), `run-part.sh`, `install-agents.sh`,
launchd wrappers for `up`/`down`/`status`, a retained Last Will per part in `connect()` and `homepod.py`, broker backoff
1-30 s, a `hands.py` restart limit in vision, `health.js`, and systemd units for camd and audiod beside servod's. Tested
without touching the running Rho (its parts were started by another session; no `sh.peak.<part>` agent was loaded):

- Throwaway agent `sh.peak.test-a` (run-part.sh `selftest`: logs, sleeps 20 s, exits 3): `kill -9` at 07:36:50, back
  at 07:36:53, which is 10 s after its previous start (the throttle); exits 3 at 07:37:13, 33, 53, each restarted at
  once; every earlier line still in `~/Library/Logs/peak/selftest.log`. `launchctl print` showed `runs = 5`,
  `last terminating signal = Killed: 9` after the kill. Booted out and the plist deleted.
- Rotation path, `sh.peak.test-b`: the log renamed to `.0` as newsyslog does, then signal 31 (SIGUSR2): `last
  terminating signal = User defined signal 2`, restarted 10 s after its start on a fresh `selftest.log`, the old lines
  in `.0`. Node and Python both end with status 159 on SIGUSR2 (killed, so launchd restarts them). newsyslog itself
  needs root and is not run.
- Own broker, `mosquitto -p 1884`: presence started by `run-part.sh` (pid of the shell = pid of node, so exec works)
  set `peak/mind/presence/status online`; after `kill -9`, `offline` with the retain flag. Voice the same. Broker
  stopped 07:40:11 and started again 07:40:31: presence logged "broker back after 5 attempts" (waits 1, 2, 4, 8, 16 s)
  and both were `online` again by 07:40:42.
- Vision with a fake `hands.py` that dies after 1 s: restarts 1, 2 and 3 of 3, then "the 4th time in a minute: giving
  up", exit 1, status `offline`.
- `health.js` every 5 s on the test broker: `ok: false, down: [mind, hearing, vision]` (not started there), Ollama up
  (7 models, 10 ms), whisper up (15 ms by HTTP), bodies from retained test statuses; after `kill -9` of presence the
  next summary added it to `down`. `npm run status` against the test broker printed all of it, and the live mind's
  `[mind] settings` line from `run/mind.log`.
- `npm run up -- mind vision` with the live hand-started parts: both refused ("already running outside launchd",
  pids named), nothing bootstrapped. `npm run down -- vision`: named the hand-started pid, killed nothing.
- `systemd-analyze verify` of the three unit files on the Pi in a temp dir: clean. `logrotate -d` of
  `node/peak.logrotate`: parses. Nothing installed on the Pi; `systemctl is-enabled` reports all three `not-found`.
- `npm test`: 78 pass (72 before, plus `senses/lib.test.js` and `orchestrator/health.test.js`).

Not yet: the cutover of the real parts, the owner's sudo steps (newsyslog, `scripts/deploy-node.sh`), a Mac reboot,
a Pi reboot, a live window.

## Pi power

Unstable (undervoltage). Needs a better supply. 5 Nov 2026 with the camera streaming and `servod` running: `throttled=0x50005` (undervoltage right now), 47 °C, load 0.25, no reboot in the first few minutes. The flag is in every sense message, so watch it from the Mac.

**Mic test, 5 Nov 2026 19:25** (`node/powerwatch.sh`, 30 s windows, 2 samples a second; the camera had held the Pi in one unbroken undervoltage since it started at 18:12:05): camera on with the mic plugged in but idle, undervoltage in 58 of 58 samples; camera on and mic streaming, 56 of 56; camera off and mic streaming, 56 of 56; camera off and mic stream off (mic still plugged in), 50 of 57. CPU held at 600-800 MHz with the camera off, 600-1200 with it on. No hang or reboot in about 4 minutes, and the mic audio arrived on the Mac (4 s clip, mean -33 dB). Not measured: the same idle window with the mic unplugged, so the mic's own share is unknown. Conclusion: this supply holds neither the camera nor the mic stream; everything today ran throttled.

**New supply, 7 Nov 2026 14:00**: the official Raspberry Pi 5.1 V 2.5 A micro-USB supply (the owner connected it and asked whether it was enough). After a reboot, idle: `throttled=0x0`, core 1.34 V, ARM 1200 MHz, 42 °C, 0 undervoltage lines in the kernel journal. Then `servod` (`PEAK_SIM=1`), `camd.sh` and `audiod.sh` started by hand, body online, and `powerwatch.sh 30`: 58 samples, undervoltage 0, freq_capped 0, throttled 0, CPU 700-1200 MHz (ondemand scaling, not a cap), kernel_dips 0, 46.7 °C, load 0.46. During the window a wave, a 4 s `laugh` eyes animation and a shrug were sent over MQTT. Conclusion: the supply holds the whole bench load. Not measured: a run of hours, and nothing with real servos, which get their own rail anyway.

## Voice (text-to-speech)

**Speaks through the HomePod mini since 5 Nov 2026** (`npm run voice`): the owner heard the test line, then two brain replies went out ("Got it." finished 3.2 s after the command, the connection kept open between lines). One line at a time, a newer one replaces a waiting one. On the Pi `say` still goes to espeak-ng, silent in sim and with no speaker attached; once a speaker is on the body, both would talk. Untested with the mic: the HomePod's own words will reach it, and a line containing "Peak" could wake the hearing gate.

**Kokoro on the Mac speaker, 8 Nov 2026 09:30-10:05** (branch `voice-kokoro`, `mind/voice/local.py`; the live Rho
kept the HomePod). Kokoro 82M (`mlx-community/Kokoro-82M-bf16`) through mlx-audio 0.6.4, voice `bm_george`, on the
Mac mini's own speakers (stream latency 13 ms). Downloads: venv 585 MB, model 340 MB, spaCy `en_core_web_sm` 13 MB.
`misaki[en]` failed to build on Python 3.13 (its transformer extra wants an old thinc); the five packages it needs
went in by hand. misaki looks for espeak-ng only in one Homebrew folder and, without it, crashed on a name missing from
its dictionary; pointing phonemizer at the `espeakng-loader` wheel's copy fixed it with no `brew`.

Bench (`kokoro_bench.py --play --runs 3`, median of 3 per line, first sound by the audio device's clock, with the live
Rho running beside it). Kokoro pads each piece with 0.27 s of silence in front and 0.52 s behind; both rows are trimmed
to 30 ms in front. "Pieces" is what `local.py` does: one per sentence, a first sentence over 60 characters cut once.

| Line | Chars | First sound, whole line (s) | First sound, pieces (s) | RTF, pieces |
| --- | --- | --- | --- | --- |
| Hey! Good to see you. | 21 | 0.17 | 0.10 | 0.079 |
| Lights off. Sleep well. | 23 | 0.21 | 0.11 | 0.082 |
| Two plus two is four. Easy one. | 31 | 0.49 | 0.17 | 0.078 |
| I'm Rho. My GeekServos are still on their way, ... | 64 | 0.51 | 0.11 | 0.093 |
| That looks like a soldering iron. Careful, ... (3 sentences) | 105 | 0.52 | 0.19 | 0.063 |
| Sure, I'll keep the desk light on for you until ... (1 sentence) | 88 | 0.38 | 0.26 | 0.076 |
| All 18 runs: p50 / max | | 0.38 / 0.83 | **0.14 / 0.27** | 0.076 |

Memory: GPU (MLX) 313 MB resident after load, 1.1 GB peak while making a line in pieces (2.1 GB peak for a 105-character
line in one piece), freed after each line; process RSS 90-350 MB. Load 0.2 s from cache, first line 1.2-3.2 s cold,
so `local.py` warms on a line of its own before it subscribes. An earlier bench run back to back with no playback, the
GPU never idle: first audio 0.06 s p50. On the CPU (`mx.cpu`) it gave no result in five minutes and was stopped.
Gate (first sound within 0.5 s): passed.

Live, on a private broker (`mosquitto -p 1884`, `PEAK_VOICE_BACKEND=kokoro PEAK_BROKER=mqtt://localhost:1884 npm run
voice`), `say` commands published by hand, played on the Mac speaker:

- Five lines 9 s apart (09:50): first sound 0.18, 0.11, 0.15, 0.10 s, then 0.83 s for the 88-character single
  sentence; `peak/mind/speaking` went `true` 0.1-0.8 s after each publish and `false` 2.3-5.6 s later.
- Newest wins: a long line, then two more 0.5 s apart. The first played, the second was never spoken, the third played
  after `waited 5.1s behind the line before`. Same result at 09:43.
- 20 lines 8 s apart (09:57-10:00), each matched against Ollama's request log: 13 with Ollama idle, first sound p50
  0.17 s, max 0.35 s; 7 while a `/api/chat` ran (the desk camera's 4B describing frames back to back), p50 0.42 s,
  max 2.03 s (the first line after five idle minutes, swap 11.2 of 12.3 GB used). All 20: p50 0.21 s, p90 0.44 s.
  No gap between pieces in any line.
- Between 09:51:15 and 09:51:42, when the 4B had just reloaded and described frames continuously, three lines took 0.70,
  0.79 and 0.83 s, with speech-making at 1.6 s instead of 0.3 s: Kokoro's many small GPU kernels queue behind
  llama-server's. That is the gate's open risk.
- `kill -TERM` printed `[voice] exiting on SIGTERM` and the Last Will set `peak/mind/voice/status offline`. A `kill -9`
  mid-line left `peak/mind/speaking` retained at `true` with the status `offline`: a hearing gate has to read both.

`talk_delay_s` in `node/config.yaml` set to 0.3 (the live median 0.21 s rounded up). It is right only with
`PEAK_VOICE_BACKEND=kokoro`; with the HomePod it must go back to 2.5, or the eyes pulse two seconds before the voice.
Not yet done: the switch of the running Rho (the LaunchAgent runs `run-part.sh`, which starts `homepod.py` directly),
`scripts/deploy-node.sh` to take the new `talk_delay_s` to the Pi, and the owner hearing the voice.

**8 Nov 2026, 11:50, the switch.** Branch merged into `main` (93 mind tests, 87 node tests pass). `run-part.sh`'s voice
line now follows `PEAK_VOICE_BACKEND`, and `up.sh`/`down.sh` find either backend by `voice/[a-z]*\.py`.
`PEAK_VOICE_BACKEND=kokoro` added to `mind/.env`; `launchctl kickstart -k` on `sh.peak.voice`: `local.py` warm in
1.5 s on 'Mac mini Speakers', `peak/mind/voice/status online` under the `voice` login.

| Check | First sound |
| --- | --- |
| Silent bench in `main`'s new venv, 12 lines in pieces | 0.08 s median, 0.12 s max (MLX peak 2.1 GB) |
| `{"say":"Hello. I speak from the Mac now."}` by hand | 0.14 s |
| Faked `heard` "rho, wave at me" through the mind (gesture 342 ms, brain 0.8 s, prefix kept) | 0.12 s |

Output volume 44, not muted, built-in speaker. The owner has not yet said he heard it. Building the venv in `main`:
GitHub answered 504 for spaCy's `en_core_web_sm` wheel for several minutes, so the package was copied from the
worktree's venv, and the wheel is now pinned in `requirements-kokoro.txt` so it installs with the venv, not at the
voice's first start. Left: `scripts/deploy-node.sh` (owner, `sudo`) to take `talk_delay_s: 0.3` to the Pi, which
still pulses the eyes 2.5 s after each line.

**8 Nov 2026, 12:05, the Pi and a spoken window.** The owner's first `deploy-node.sh` copied `node/` at 11:47 but left
servod running from 09:52 (it reads `config.yaml` once, at start). servod was restarted through systemd at 12:05:33
(`Restart=always`, one servod, `talk_delay_s: 0.3`, display on). Then a 60 s window, the owner asked for "wave",
"lights off", "lights on". Five utterances passed the wake gate (four on "Rho", one in the attention window), each
0.4 s after speech ended:

| Reply, in order | Gesture out | Reply done | Voice first sound |
| --- | --- | --- | --- |
| `*wave*` "Hey there!" | 319 ms | 711 ms | 0.35 s |
| `[light_on]` | 285 ms | 691 ms | (no line) |
| `[light_off]` | 309 ms | 705 ms | (no line) |
| `*wave*` "Hey there!" | 287 ms | 717 ms | 0.21 s |
| eyes `happy`, no words | 291 ms | 701 ms | (no line) |

Every prompt kept the cached prefix (prompt eval 134-149 ms). The light ended `OFF`: on came before off, the reverse of
the asked order. Transcripts are not logged (`PEAK_DEBUG` off), so which words gave which reply is the owner's to say.
The device replies carry no spoken line, so the voice spoke for two of the five. The owner, 12:10: the voice came from
the Mac and the eyes pulsed with it ("both in step").

## Desk light (device)

**7 Nov 2026, built and lit.** ESP32-C3 SuperMini + nRF24L01+ on seven F/F jumpers (CE 10, CSN 7, SCK 4, MOSI 6, MISO 5,
3V3, GND), the owner's first soldering job (the two header strips), lightbar2mqtt 0.3 flashed with `arduino-cli`
(esp32 core 3.3.12, `CDCOnBoot=cdc`). Radio check passed first time. Wi-Fi joined only after `WiFi.setTxPower(8.5 dBm)`
(the SuperMini antenna trap): minutes of retries before, 2 s after. Board `l2m_E8F60A4E22A8`, IP 192.168.0.18; the
puck's serial `0x08D722` heard four times in one press-and-turn. With the stock single-channel send (68) the bar went
off but never back on; sending the burst over channels 6, 15, 43 and 68 fixed it: off-on-off-on, four of four on the
glass, 9 s apart. By voice, with the mind on `PEAK_BRAIN_DEVICES=1`: "Row, light off" → light_off, "Bro, dim the
light" (inside the attention window) and "Ro, dim the light" → light_dim, five of five brain picks right, 0.6-0.8 s
each, the bar following. Dropped by the wake gate outside the window: "Bro ..." three times, "Roar!" and "Rome" once
each. MQTT link flapped once during a radio burst on the first run, not again in three later runs.

**Evening of 7 Nov 2026, the light moved to ESPHome on the ESP32-C6.** On the C3 the Wi-Fi was the weak link (14 drops an
hour, each radio burst knocking it off the broker) and a persistent session replayed stale toggles; on the C6 with
lightbar2mqtt the puck was heard but no transmission reached the bar at any power or SPI speed. The owner's pick:
the `xiaomi_lightbar` ESPHome component (juancase/kriodoxis). First ESP-IDF build 12 min, OTA after. With the node's
memory set by its calibrate button: off, on, dim, bright, warm, cool each on the glass, the first level move absolute
and every later one a single relative step; the link held through every burst. By voice, with "bro" added to the wake
homophones at the owner's word (whisper wrote every Rho as Bro that evening): "Bro, lights off", "Bro, lights on",
"Bro, dim the lights" all on the glass. Also that evening: `servod` died silently once, `up.sh`'s pgrep guard matched
itself (now pid files), a `pkill` pattern killed its own ssh line while restarting the mic stream, and one brain call
took 43 s (Ollama swap) in the middle of a voice window.

## Desk rig (printed parts for the monitor arm)

**Designed 8 Nov 2026, 03:00-04:00, nothing printed or tested yet.** A 14-agent research and design pass (four hours): six research angles (the arm, the boards, sonar physics, the mic, brick-compatible printing, overhead-rig patterns), three independent designs, two judges, a critic with 22 findings, all applied. The model is `hardware/desk-rig/rig.scad` (8 printed parts, about 330 g of PETG; the carrier alone 331 cm³ solid, about 230 g printed), rendered with OpenSCAD 2026.10.11; the owner's guide with the drawings is linked from `CLAUDE.md`. What decided it:

- **The arm** is a North Bayou NB F80 or a clone of it (grey links with white covers, X-shaped VESA plate): load 2-9 kg, tilt +85°/-30°, 260 mm lift, 530 mm reach, VESA 75/100, M4. The head carries about 0.2 kg today, under the gas spring's 2 kg minimum, which is why the arm sits at its top stop in the 7 Nov photo; no tension setting holds a lighter load. Fix: 2 kg of ballast at the head (strap weights now, a 120 x 120 x 20 mm steel plate from `ballast.dxf` later), then the 5 mm hex screw under the upper arm toward "-". The gas-strut link is a parallelogram: the photo shows the plate 30° face-down with the link 50° up, impossible with a single pivot, so a camera hung at 90° from the plate stays plumb through the lift. The plate cannot face down (-30° stop), so the carrier's plate leans 30° and the head is left on its stop: gravity, not friction, sets pitch. The stop angle is the first thing the owner must measure (phone level, five tries, within 0.5°); 0-40° prints without supports, `STOP_DEG = 0` is the vertical-plate fallback.
- **Boards**, from the manufacturers' drawings: Pi 3B holes 58 x 49 (M2.5, 3.5 mm from the SD edge and the long edges), CSI connector 45.5 mm from the SD edge, SoC centre 27.0 / 31.5; Camera Module 3 Wide 25 x 23.86, holes 21 x 12.5 (Ø2.2, 2.0 and 14.5 from the cable edge), lens 14.4 from the cable edge, 102° x 67°, barrel 8.3 mm proud, 818 px focal length on the 1920x1080 stream (0.79 mm/px at 650 mm); HC-SR04 cans Ø16 about 26 apart, ±15°, 348 mm spot at 650 mm; HC-SR501 holes 28 apart, dome Ø23; GY-521 holes about 15.5; 0.96" OLED 27.3 x 27.8 or 27 x 27, holes 22.3 x 23.0 Ø2.8, pins usually perpendicular to the board.
- **Height accuracy**: 3 mm by datasheet; the speed of sound costs 1.15 mm per °C at 650 mm, so the KY-001 DS18B20 from the sensor kit goes under the rig in free air (the Pi's 47 °C SoC reading would add 29 mm); a tilt of θ reads h/cos θ (0.4 % at 5°, nothing); the cans must never touch plastic (structure-borne ringing reads as a short echo). VL53L1X rejected: ±20-25 mm by datasheet and marginal on a dark desk under a lamp. The LD2410C cannot measure this (0.75 m gates).
- **The mic** is a Trust GXT 232 Mantis: 150 x 50 x 35 mm, 120 g, omnidirectional condenser, fixed 1.5 m USB-A lead, no stand thread. It already scores 4.5 % word errors at the desk (2 Nov), so it stays, in a foam-lined ring on a 150 mm bar: about 210 mm forward of the lens, 70° off the camera's axis, far outside the sonar cone. Omnidirectional means the HomePod is handled by distance (2 m) and a software gate, not by pointing.
- **Brick printing**: shop FDM lands ±0.1-0.2 mm, the whole clutch budget, and Brickset's test found printed clutch "nowhere near" real. So nothing printed carries clutch: a real 4x8 plate glues into a pocket on the perch, real Technic pins go into Ø4.9 holes (the coupon picks 4.8-5.1), and Rho is built from about 60 real bricks (list in the guide) with the OLED on a tiny printed sled.
- **Material**: PETG, light grey or white. PLA creeps at desk temperature (HDT 55 °C, rupture in hours at 15 MPa); PETG's HDT is 68 °C; dark PETG by the window would pass 60 °C under the 2.7 kg head load.
- **Tooling**: the Homebrew `openscad` cask is disabled (Gatekeeper, since Sep 2026); `openscad@snapshot` needs `--appdir=$HOME/Applications` or it asks for sudo to copy into `/Applications`. The CLI renders STL, PNG and DXF; `hardware/desk-rig/render.sh` does all of it in two seconds.
- **Not yet measured** (before anything is printed): the stop angle and its repeatability, the X-plate's span and centre boss, the mic's neck, which OLED and sonar variants he has, what lies under the sonar at the working position, the mouth-to-ring distance. Nothing has met the body: no print, no fit test, no live run.
