prbstr/peak/docs/environment.md

# Environment facts, in full

`CLAUDE.md` has what a new chat needs. This file keeps the rest: versions, dates, what was checked and when. Facts
here were true on the date they carry; check before relying on one.

- Mac: Mac mini, 24 GB unified memory. Mac IP on the LAN is `192.168.0.139` (interface `en1`, not `en0`; `ipconfig getifaddr en1`).
- Pi: `lupin@mech.local` (192.168.0.226 at last check), key login works, **`sudo` needs a password** so Claude cannot install packages. Ask the owner to run `sudo` lines.
- Attached to the Pi on 5 Nov 2026 (Communica order, wired per the Claude Doc "peak — Bench wiring guide", https://claude.ai/artifact/VFhBowXNv9TeSvXViN2TWc, tab "Connect now"): Camera Module 3 Wide (`imx708_wide`), OLED at I2C `0x3c`, HC-SR04+ on GPIO23 trig / GPIO24 echo (3.3 V), PIR on GPIO17. The owner bench-tested all of these plus the MPU6050 (`0x68`) on 5 Nov; all passed. The MPU6050 takes turns with the OLED on the same four pins until a breadboard arrives, and the OLED was the one connected at 18:00. No USB mic was plugged in at that check. The venv was rebuilt with `--system-site-packages` (gpiozero, lgpio from apt; luma.oled, smbus2, Adafruit PCA9685 from pip; **not** `adafruit-circuitpython-neopixel-spi`). `i2cdetect` is `/usr/sbin/i2cdetect` over non-login ssh.
- Pi header, physical pins, as wired with F/F jumpers: OLED or MPU6050 on 1 (3.3 V), 9 (GND), 3 (SDA), 5 (SCL); PIR on 2 (5 V), 6 (GND), 11 (OUT); HC-SR04+ on 17 (3.3 V), 20 (GND), 16 (Trig), 18 (Echo). Planned once a breadboard, M/F jumpers and a soldering iron are here (GPIO numbers stay the same): fan on 4 and 14, vibrator motor through a BC337 from pin 13 (GPIO27), NeoPixel DIN on pin 19 (GPIO10, SPI). The NeoPixel needs SPI enabled, `core_freq=250` in `/boot/firmware/config.txt` and the neopixel-spi package; none of the three is in place (checked 5 Nov), and the first two need `sudo`. PCA9685 servo power (V+) comes from the 5 V buck, never the Pi.
- A second handover is kept in the owner's claude.ai Project (also named "lupin") and is not on disk; the owner pastes it in. Its 5 Nov 18:05 copy was well behind this repo (it still described a Claude-API mind, no commits and the hostname `slav`). Checked against the Pi that evening: hostname, key-only ssh, I2C, watchdog (10 s), `mosquitto-clients` and the venv are all done. This file is the one to trust; take hardware news and the owner's plans from the pasted one.
- HomePod mini: AirPlay name **Bedroom**, `192.168.0.191`, tvOS 27.2, model `AudioAccessory5,1`, AirPlay open to the network (no pairing needed), volume 33 on 5 Nov 2026. It was the only AirPlay speaker `dns-sd -B _raop._tcp` found; the first-gen HomePod did not show up.
- Ollama: Homebrew service, **0.40.13** since 3 Nov 2026 (was 0.24.0; `brew upgrade ollama` kept the plist below intact, then `launchctl bootout/bootstrap` to reload). 0.40 runs Qwen3-VL on llama-server, not Ollama's own engine: brain 0.4 s and 5.3 GB (was 0.5 s, 7 GB) but a fresh photo takes 5.6 s instead of 1.8 s, and the scheduler evicts on free *system* RAM too. Downgrading to 0.24.0 means `brew extract` of the old formula (no bottle cached). Config in `~/Library/LaunchAgents/sh.brew.ollama.plist` (flash attention, q8 KV cache, `OLLAMA_MAX_LOADED_MODELS=2`, `OLLAMA_KEEP_ALIVE=30m`). Reload with `launchctl bootout/bootstrap`, not `brew services restart` (it rewrites the plist). Live log: `/opt/homebrew/var/log/ollama.log` (`~/.ollama/logs/server.log` is stale). The GPU gets about 17.8 GB of the 24 GB. Another program also loads `qwen3:14b` (12 GB at 32K ctx) or `qwen2.5-coder:7b` into Ollama at times; do not stop it, but expect it to evict our models when the total passes the budget.
- The shell tool cannot write to `/tmp` for ffmpeg outputs reliably; use `mktemp -d` dirs.
- Ollama models (cleanup 4 Nov 2026, freed about 66 GB): peak keeps only `huihui_ai/qwen3-vl-abliterated:8b-instruct` (brain and eyes) and `huihui_ai/qwen3.5-abliterated:9b` (accuracy option, kept for fun). Removed: both Gemma 4 12B, `qwen3-abliterated:8b`, `richardyoung/qwen3-14b-abliterated`, `qwen2.5vl:3b`, `moondream`; re-pull to rerun old bake-offs. Everything else belongs to OpenClaw (`~/.openclaw/openclaw.json` and `agents/main/agent/models.json`: `qwen3:14b`, `qwen2.5-coder:7b-instruct`, `nomic-embed-text`, `llama3.1:8b`); do not remove those. `qwen3-coder:30b` and `gemma4:26b` were removed at the owner's request (4 Nov 2026, 35 GB) and taken out of `models.json` too (backup: `models.json.bak-20261104`). Lupin uses no Ollama models. Code fallbacks for `PEAK_MODEL` and `PEAK_VISION_MODEL` now name Qwen3-VL.
- Whisper: whisper.cpp `whisper-server` on 127.0.0.1:8178, `ggml-medium.en.bin` (and `ggml-small.bin`) in `~/.cache/whisper.cpp`. The old openai-whisper CLI (`~/.cache/whisper`) is still installed but unused.
- STT bake-off harness in `mind/bakeoff/` (own venv at `mind/bakeoff/.venv`, python3.13: moonshine-voice, parakeet-mlx, jiwer). Models cached by Moonshine and Hugging Face on first run.
