prbstr/peak/desk-camera-mockup.jpg

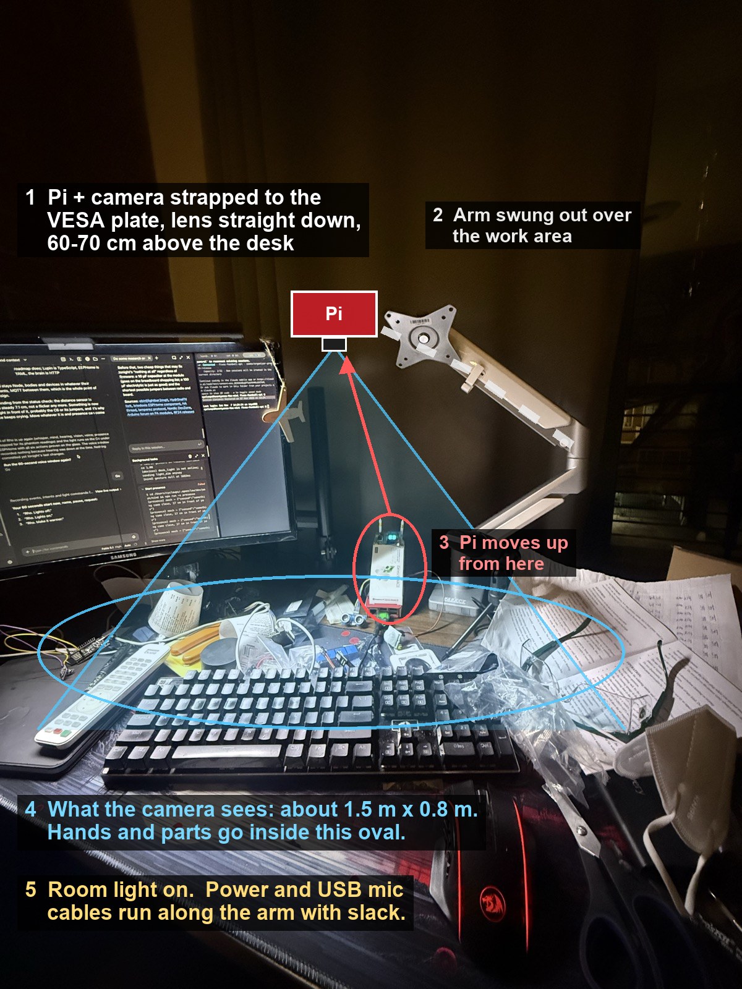
desk-camera-mockup.jpg
