prbstr/peak/hardware/desk-rig/png/ballast.png

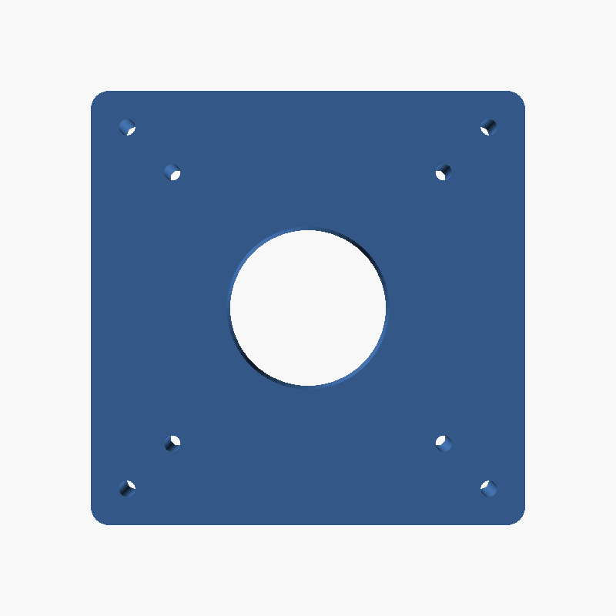
hardware/desk-rig/png/ballast.png
