prbstr/peak/hardware/desk-rig/png/carrier.png

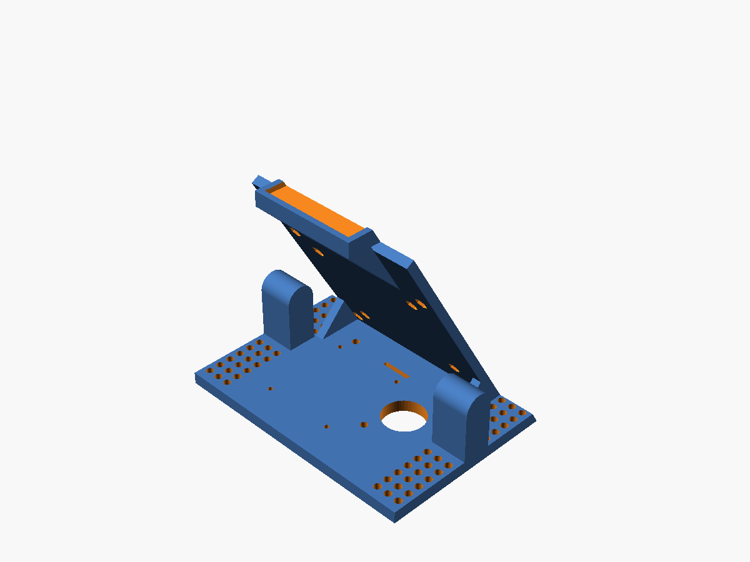
hardware/desk-rig/png/carrier.png
