prbstr/peak/hardware/desk-rig/png/coupon.png

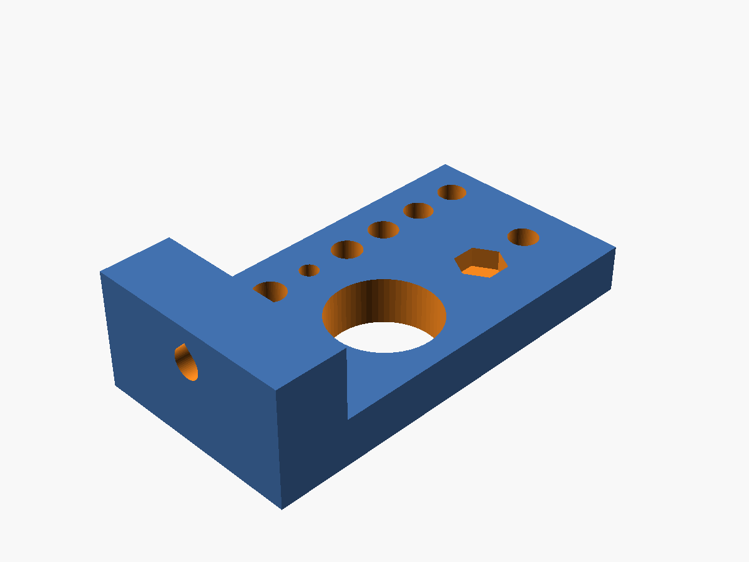
hardware/desk-rig/png/coupon.png
