prbstr/peak/hardware/desk-rig/png/micbar.png

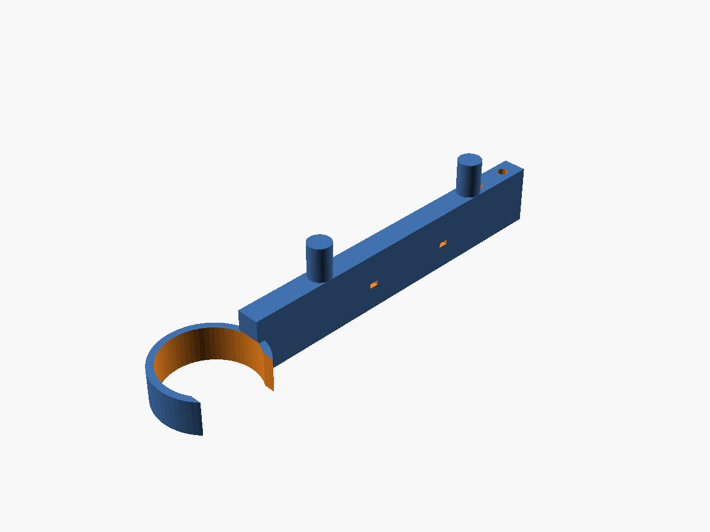
hardware/desk-rig/png/micbar.png
