prbstr/peak/hardware/desk-rig/png/outrigger.png

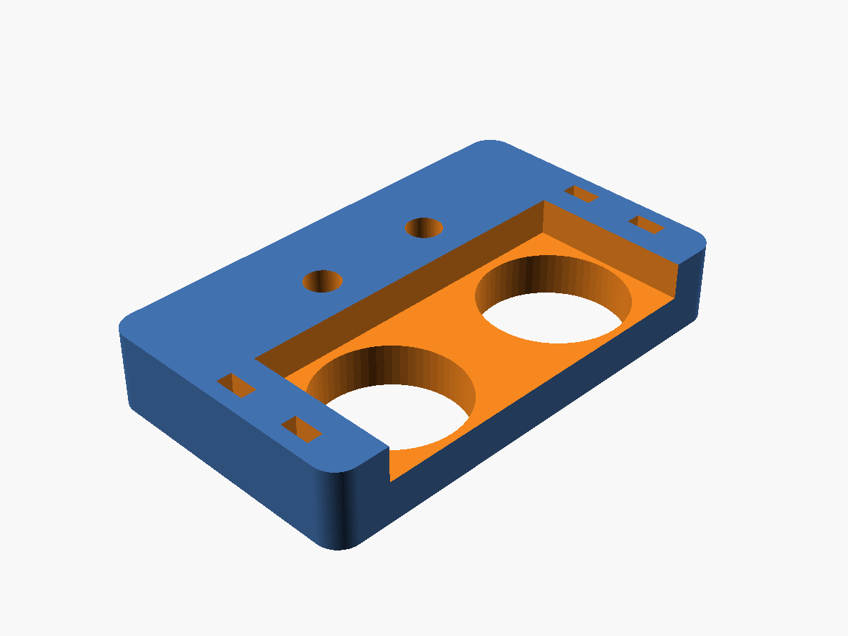
hardware/desk-rig/png/outrigger.png
