prbstr/peak/hardware/desk-rig/png/pirwedge.png

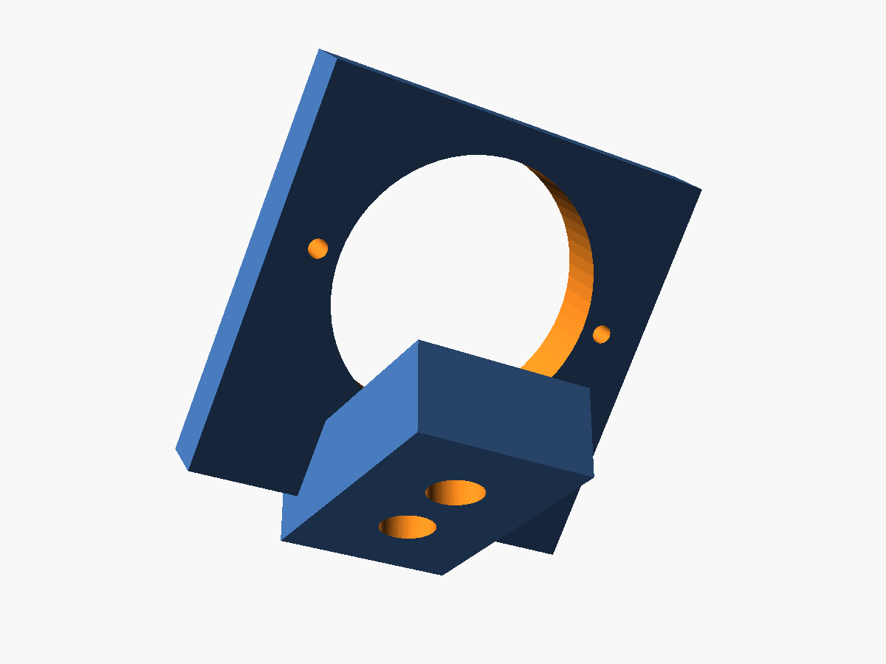
hardware/desk-rig/png/pirwedge.png
