prbstr/peak/hardware/desk-rig/png/pod.png

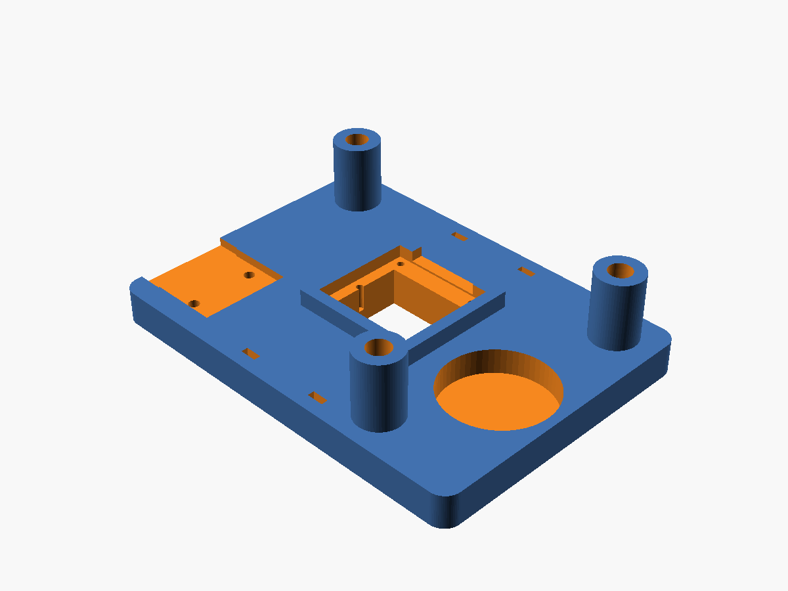
hardware/desk-rig/png/pod.png
