prbstr/peak/hardware/desk-rig/png/shims.png

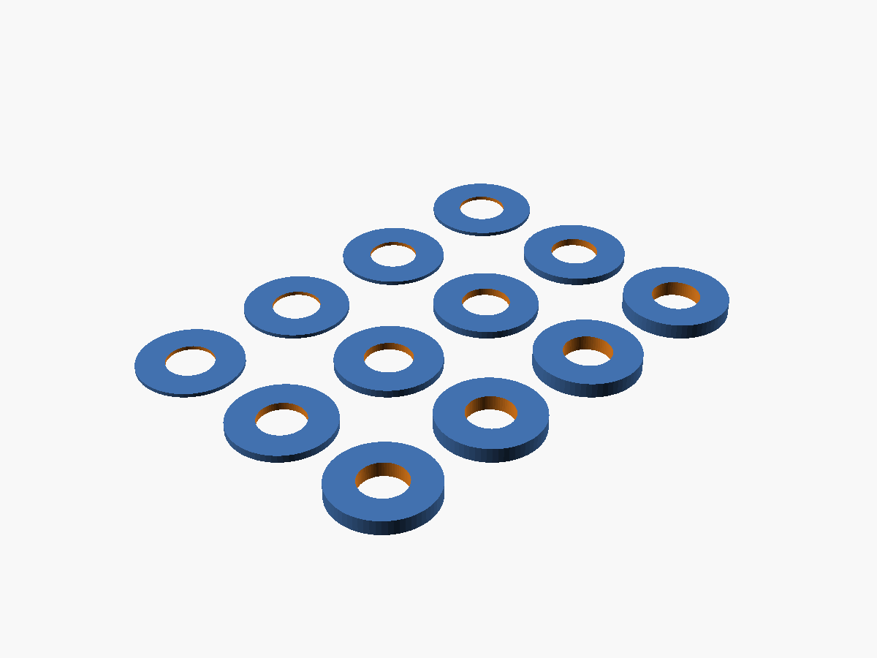
hardware/desk-rig/png/shims.png
