prbstr/peak/hardware/desk-rig/png/sled.png

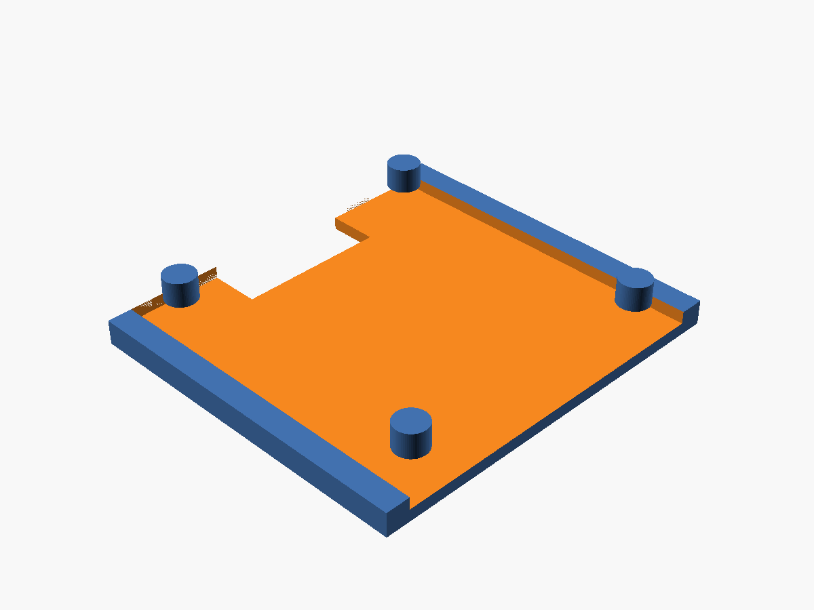
hardware/desk-rig/png/sled.png
