prbstr/peak/shopping/cart-desk-light.md

# Cart brief: desk light hack

For a browser agent (Claude in Chrome, ChatGPT Atlas, etc.). Fill the cart only.

## Rules
- Do NOT check out, pay, enter card details, or change account/address settings. Stop at the cart page and report.
- Prefer one store for everything (shipping). Order of preference: Communica, Micro Robotics, DIY Electronics.
- If an item is out of stock, try the next store, then report. Don't substitute anything outside "acceptable".
- Don't add extras, warranties or insurance.

## Items
| # | Item | Qty | Search for | Acceptable | Not acceptable | Max price each |
|---|---|-----|---|---|---|---|
| 1 | ESP32 dev board | 1 | "ESP32 WROOM-32 dev board" | ESP32-WROOM-32 or DevKitC, USB on board, pin headers fitted | ESP32-CAM, ESP8266, ESP32-C3/S2 boards, bare modules | R180 |
| 2 | nRF24L01+ module | 1 | "nRF24L01+ transceiver module" | nRF24L01+ with PCB antenna, 8-pin 2x4 header | PA+LNA version with an external antenna, SMD "mini" version (1.27 mm pitch), adapter boards on their own | R70 |
| 3 | F-F jumper wires | 8+ | "female to female jumper wires" | 10–20 cm dupont, pack of 10–40 | M-M or M-F only | R50/pack |
| 4 | 10 µF capacitor | 2 | "10uF electrolytic capacitor" | 10 µF, 16 V or higher | SMD | R10 |

Known links (checked 6 Nov 2026; stock not checked):
- https://www.communica.co.za/products/bmt-esp-32-wifi-b-t-dev-board
- https://www.communica.co.za/products/bmt-nrf24l01-transceiver-module (listed as sold out)

## Report back
Store, each item with name + price + qty + link, cart total incl. shipping, anything skipped and why. Then stop.
