prbstr/peak/hardware/desk-rig/stl/shims.stl

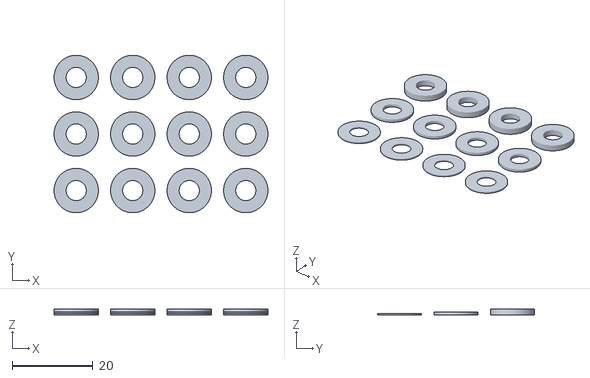
[picture p12: CAD file, 2026-11-08]
hardware/desk-rig/stl/shims.stl
53.0 x 39.0 x 1.60
