prbstr/peak/hardware/desk-rig/stl/micbar.stl

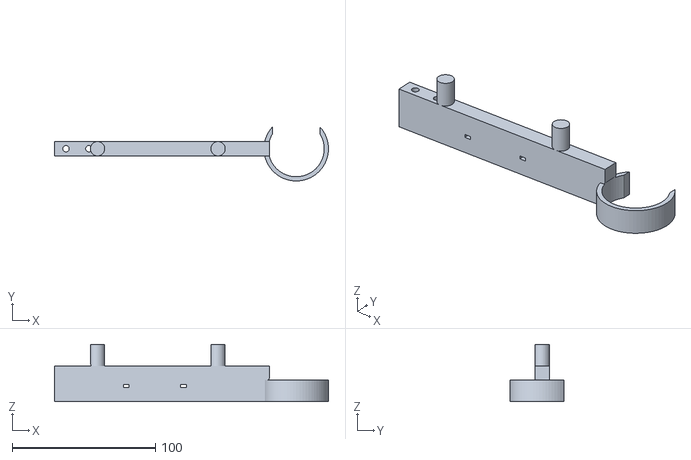
[picture p13: CAD file, 2026-11-08]
hardware/desk-rig/stl/micbar.stl
191.0 x 37.7 x 40.0
