prbstr/peak/hardware/desk-rig/stl/coupon.stl

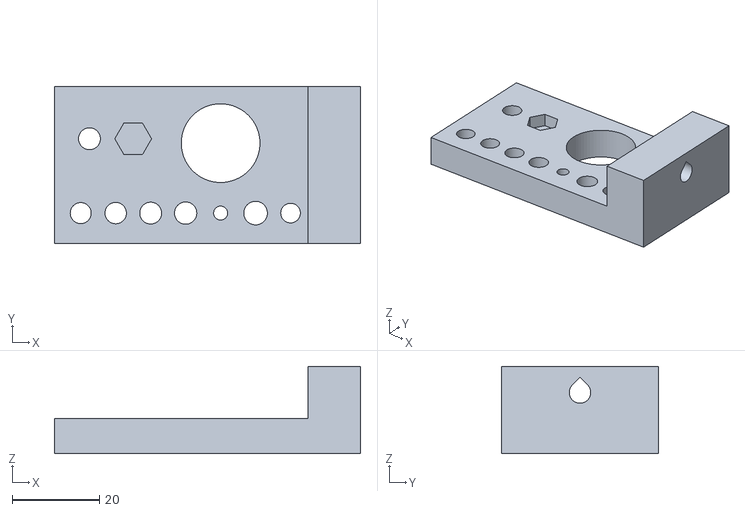
[picture p14: CAD file, 2026-11-08]
hardware/desk-rig/stl/coupon.stl
70.0 x 36.0 x 20.0
