prbstr/peak/hardware/desk-rig/stl/carrier.stl

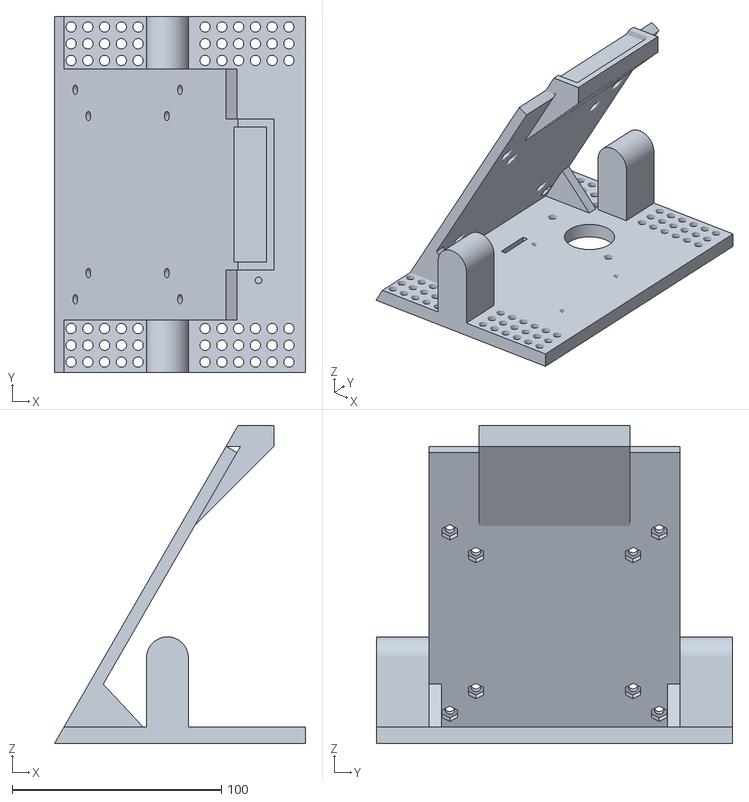
[picture p15: CAD file, 2026-11-08]
hardware/desk-rig/stl/carrier.stl
120.0 x 170.0 x 152.0
