prbstr/peak/hardware/desk-rig/stl/pirwedge.stl

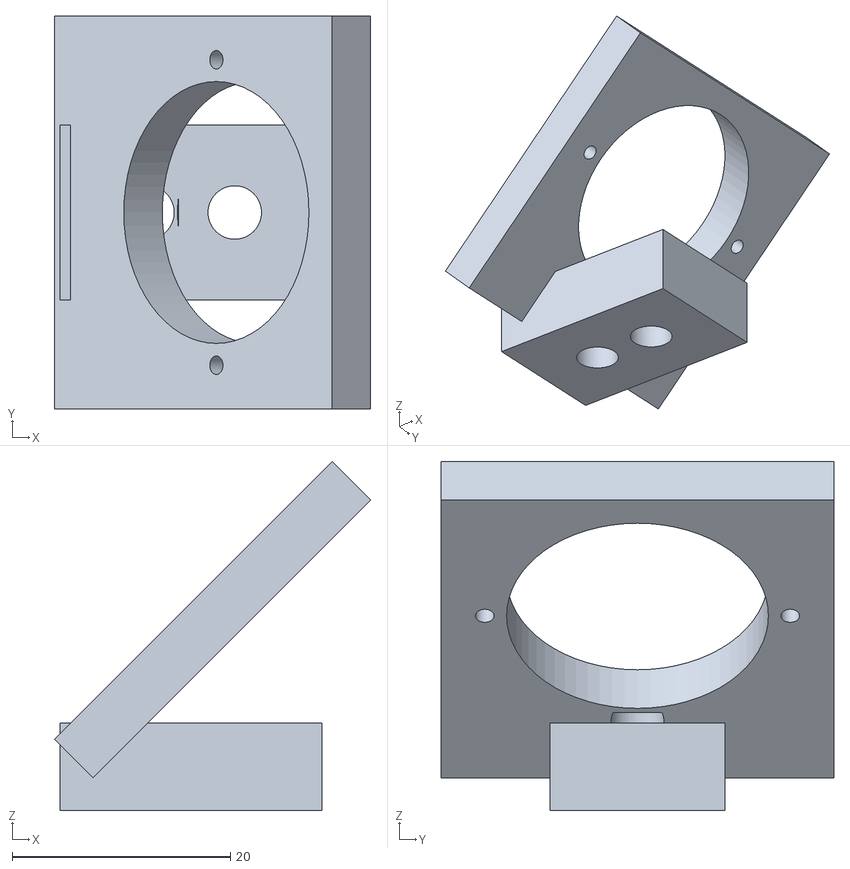
[picture p16: CAD file, 2026-11-08]
hardware/desk-rig/stl/pirwedge.stl
29.0 x 36.0 x 32.0
