prbstr/peak/hardware/desk-rig/stl/pod.stl

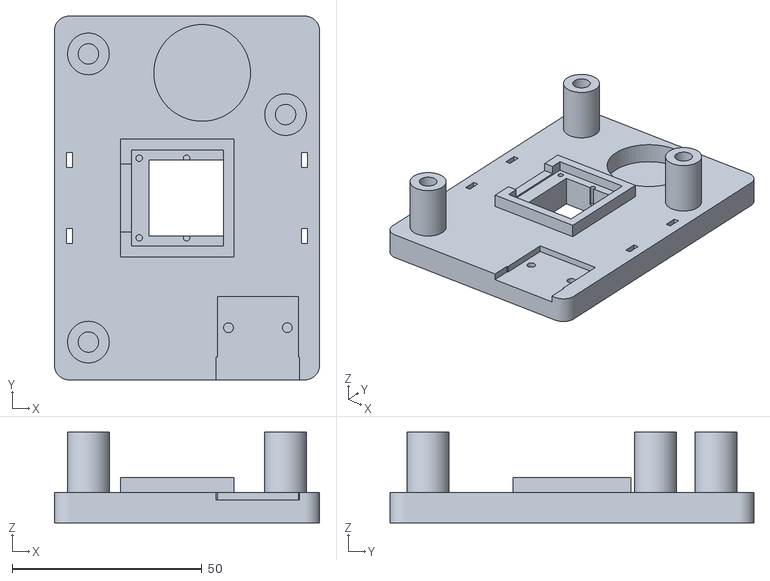
[picture p17: CAD file, 2026-11-08]
hardware/desk-rig/stl/pod.stl
70.0 x 96.0 x 24.0
