prbstr/peak/hardware/desk-rig/stl/sled.stl

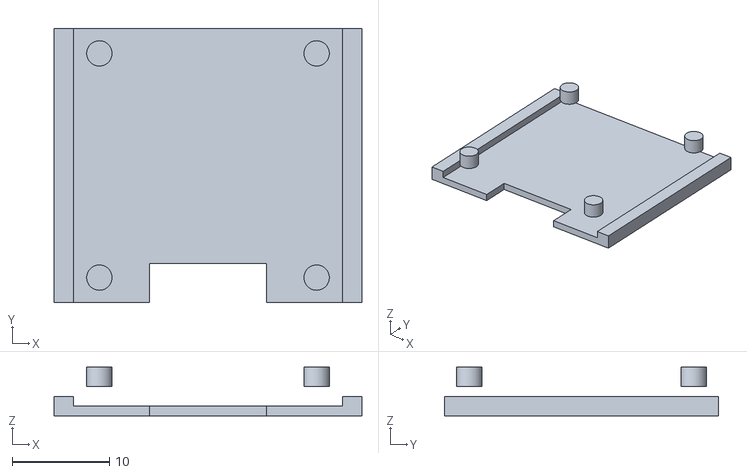
[picture p18: CAD file, 2026-11-08]
hardware/desk-rig/stl/sled.stl
31.6 x 28.1 x 5.00
