prbstr/peak/hardware/desk-rig/stl/outrigger.stl

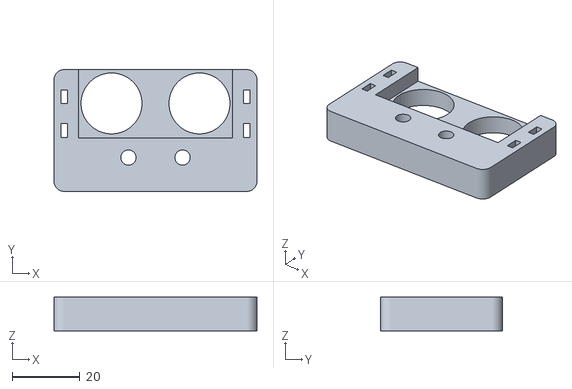
[picture p19: CAD file, 2026-11-08]
hardware/desk-rig/stl/outrigger.stl
60.0 x 36.0 x 10.0
