prbstr/peak/(list of files, cad)

Other CAD files:
hardware/desk-rig/ballast.dxf
