prbstr/peak/hardware/desk-rig/png/assembly-below.png

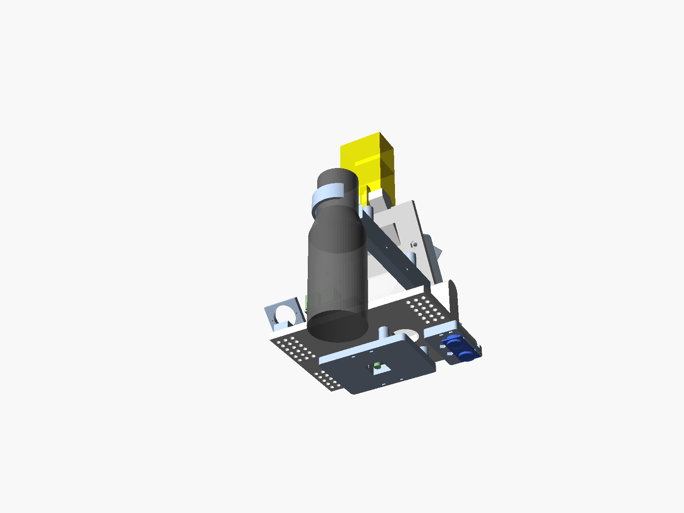
hardware/desk-rig/png/assembly-below.png
