prbstr/peak/hardware/desk-rig/png/assembly-front.png

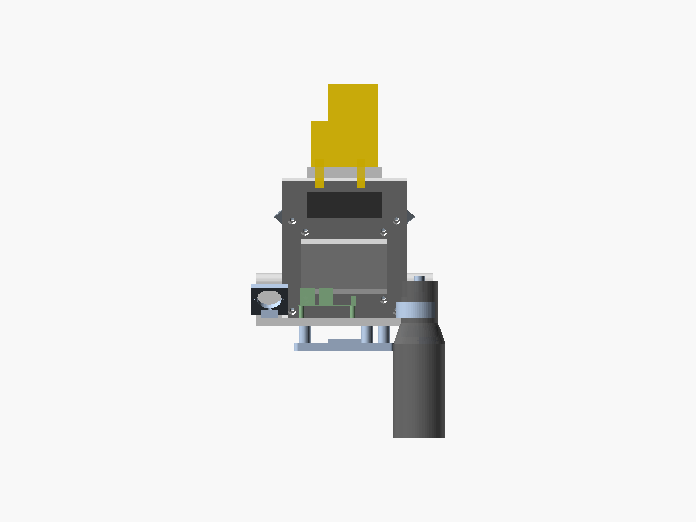
hardware/desk-rig/png/assembly-front.png
