prbstr/peak/hardware/desk-rig/png/assembly-side.png

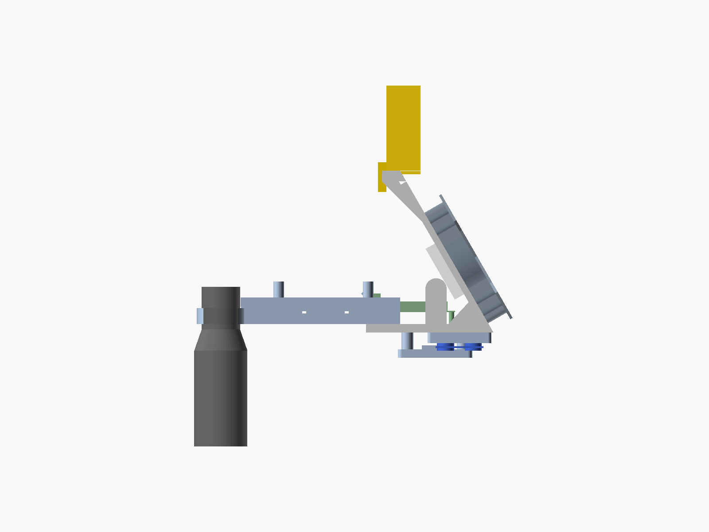
hardware/desk-rig/png/assembly-side.png
