prbstr/peak/node/servod.py

#!/usr/bin/env python3
"""peak node — servo daemon.

Subscribes to peak/<node>/cmd and drives a PCA9685 with eased, clamped moves.
Publishes peak/<node>/sense every few seconds and peak/<node>/status (retained,
with a Last Will) so the mind knows which bodies are alive. Runs on a Raspberry Pi 3B.

Set PEAK_SIM=1 to run without hardware (prints moves instead).
"""
import json, os, queue, signal, subprocess, time, threading
from pathlib import Path
import yaml
import paho.mqtt.client as mqtt
from screen import Screen
from cmdcheck import validate_cmd
from deadman import DeadMan, MIND_STATUS_TOPIC

HERE = Path(__file__).parent
CFG = yaml.safe_load((HERE / "config.yaml").read_text())
GESTURES = yaml.safe_load((HERE / "gestures.yaml").read_text())
NODE = os.environ.get("PEAK_NODE", CFG["node"])
BROKER = os.environ.get("PEAK_BROKER", "localhost")
BROKER_PORT = int(os.environ.get("PEAK_BROKER_PORT", "1883"))  # another port for a test broker beside the live one
SIM = os.environ.get("PEAK_SIM") == "1"
STATUS_TOPIC = f"peak/{NODE}/status"
BOOT_SETTLE_MS = 1000  # ease to rest on boot: six servos snapping at once browns out the rail
# How soon a dead link is noticed: paho pings after this many seconds with nothing heard and gives up after as many
# again, and the broker sends the body's Last Will after 1.5 times it. Was 60, which noticed a Wi-Fi drop after
# up to two minutes, long after any move had ended; the dead-man switch needs it short (deadman.py).
KEEPALIVE_S = int(os.environ.get("PEAK_KEEPALIVE_S", "5"))

# ---------- hardware ----------
class Servos:
    def __init__(self):
        self.pos = {name: s["rest"] for name, s in CFG["servos"].items()}
        self.stop_flag = threading.Event()
        self.moving = threading.Event()
        self.kit = None
        if SIM:
            return
        from pca9685 import PCA9685
        self.kit = PCA9685(address=CFG["i2c_address"], frequency=CFG["servo_hz"])
        self.settle()

    def settle(self):
        """Bring every servo to rest gently, one at a time, so startup current stays low."""
        for name, s in CFG["servos"].items():
            self.pos[name] = s["rest"]  # unknown real position; easing from rest is the safest assumption
            self.write(name, s["rest"])
            time.sleep(BOOT_SETTLE_MS / 1000 / len(CFG["servos"]))

    def pulse_us(self, deg):
        """Map an angle to a pulse width across the servo's full actuation range."""
        lo, hi = CFG["pulse_us"]
        return lo + (deg / CFG["actuation_range"]) * (hi - lo)

    def write(self, name, deg):
        s = CFG["servos"][name]
        deg = max(s["min"], min(s["max"], deg))
        self.pos[name] = deg
        if self.kit:
            self.kit.set_pulse_us(s["ch"], self.pulse_us(deg))
        else:
            print(f"[sim] {name} -> {deg:.0f}")

    def move(self, targets: dict, ms: int):
        """Ease all servos in `targets` from current to target over `ms` (smoothstep). Stops early on stop()."""
        start = {n: self.pos[n] for n in targets}
        steps = max(1, int(ms / 20))
        for i in range(1, steps + 1):
            if self.stop_flag.is_set():
                return
            t = i / steps
            e = t * t * (3 - 2 * t)
            for n, target in targets.items():
                self.write(n, start[n] + (target - start[n]) * e)
            time.sleep(0.02)

    def gesture(self, name):
        frames = GESTURES.get(name)
        if not frames:
            print(f"[servod] unknown gesture {name}")
            return
        for f in frames:
            if self.stop_flag.is_set():
                return
            ms = f.get("ms", 300)
            targets = {k: v for k, v in f.items() if k != "ms" and k in CFG["servos"]}
            if targets:
                self.move(targets, ms)
            else:
                time.sleep(ms / 1000)

    def release(self):
        """Let every servo go limp. Today's {"stop": true} does this after cancelling the motion; the dead-man
        switch does not (a limp arm drops under gravity)."""
        for s in CFG["servos"].values():
            if self.kit:
                self.kit.release(s["ch"])
        if not self.kit:
            print("[sim] stop: all servos released")

servos = Servos()

# ---------- motion queue ----------
# One move at a time, at most one waiting. A newer command replaces the waiting one:
# a robot should do the latest thing it was told, not catch up on a backlog.
motion = queue.Queue(maxsize=1)
# Each queued command carries the number of cancels (stops and dead-man holds) made before it. The worker drops one
# that a cancel has overtaken, and clears stop_flag under the same lock a cancel sets it under, so a stop can no
# longer land between motion.get() and the clear and be lost (the race written down in docs/decisions.md, 8 Nov).
motion_lock = threading.Lock()
cancels = [0]

def enqueue_motion(cmd):
    with motion_lock:
        item = (cancels[0], cmd)
        try:
            motion.put_nowait(item)
        except queue.Full:
            try:
                motion.get_nowait()
            except queue.Empty:
                pass
            motion.put_nowait(item)

def cancel_motion():
    """Drop the waiting move and abort the running one. The servos stay where the cancel found them."""
    with motion_lock:
        cancels[0] += 1
        try:
            motion.get_nowait()
        except queue.Empty:
            pass
        servos.stop_flag.set()

def motion_worker():
    """Runs every move. on_message has checked each command already; this catch is the second line, so that one
    bad move can never end the thread and leave a body that senses and looks online but no longer moves."""
    while True:
        made_at, cmd = motion.get()
        with motion_lock:
            if made_at != cancels[0]:
                continue  # a stop or a hold came after it was queued
            servos.stop_flag.clear()
            servos.moving.set()
        try:
            if "gesture" in cmd:
                servos.gesture(cmd["gesture"])
            elif "servo" in cmd:
                servos.move({cmd["servo"]: float(cmd["deg"])}, int(cmd.get("ms", 300)))
        except Exception as e:
            print(f"[servod] motion failed on {json.dumps(cmd)[:120]}: {e!r}")
        finally:
            servos.moving.clear()

motion_thread = threading.Thread(target=motion_worker, daemon=True)
motion_thread.start()

# ---------- sensors ----------
class Sensors:
    """GPIO sensors from config.yaml `sensors`. Real whenever the pins exist, even with PEAK_SIM=1:
    a body with no servos wired yet can still sense. On a machine without GPIO (the Mac) each stays None."""
    def __init__(self):
        cfg = CFG.get("sensors") or {}
        self.ultrasonic = self.open("ultrasonic", cfg, lambda g, c: g.DistanceSensor(
            echo=c["echo"], trigger=c["trig"], max_distance=c.get("max_cm", 400) / 100))
        self.pir = self.open("pir", cfg, lambda g, c: g.MotionSensor(c["out"]))

    @staticmethod
    def open(name, cfg, make):
        if name not in cfg:
            return None
        try:
            import gpiozero, warnings
            # no echo is normal with nothing in range; it would fill the log
            warnings.simplefilter("ignore", gpiozero.DistanceSensorNoEcho)
            return make(gpiozero, cfg[name])
        except Exception as e:
            print(f"[servod] no {name} sensor: {e}")
            return None

    def read(self):
        out = {}
        if self.ultrasonic and self.ultrasonic.value < 1:  # 1.0 is "no echo", not a distance
            out["distance_cm"] = round(self.ultrasonic.distance * 100, 1)
        if self.pir:
            out["motion"] = bool(self.pir.motion_detected)
        return out

sensors = Sensors()

THROTTLED_EVERY_S = 5  # it costs a subprocess, and power does not change as fast as distance does
throttled = {"at": float("-inf"), "value": None}

def read_throttled():
    """Pi firmware power flags as hex, e.g. 0x50005. Bit 0 set means undervoltage right now."""
    if time.monotonic() - throttled["at"] < THROTTLED_EVERY_S:
        return throttled["value"]
    throttled["at"] = time.monotonic()
    try:
        r = subprocess.run(["vcgencmd", "get_throttled"], capture_output=True, text=True, timeout=2)
        throttled["value"] = r.stdout.strip().split("=")[1]
    except Exception:
        throttled["value"] = None
    return throttled["value"]

def read_sense():
    out = {"uptime": time.monotonic(), "pos": servos.pos, "motion_alive": motion_thread.is_alive(), **sensors.read()}
    try:
        out["temp"] = float(Path("/sys/class/thermal/thermal_zone0/temp").read_text()) / 1000
    except Exception:
        pass
    flags = read_throttled()
    if flags:
        out["throttled"] = flags
    return out

# ---------- display ----------
HEAL_EVERY_S = 5
FULL_EVERY_S = 60   # the panel cannot be read back, so now and then it is sent everything
FPS_CAP = 15
SWEAT_FPS = 8       # with nothing else moving, falling drops get by on fewer frames
STATS = os.environ.get("PEAK_FACE_STATS")  # "1" logs the cost of drawing; "full" also sends whole frames, to compare
STATS_EVERY_S = 10

class Display:
    """SSD1306 OLED from config.yaml `display`: shows screen.py's eyes. One thread does all the drawing; the
    mqtt thread and the sense loop only tell the screen what happened and wake it. Real whenever it answers
    on I2C, like the sensors. A display that is missing or unplugged mid-run (on the bench it shares its
    pins with the MPU6050) never stops servod."""
    def __init__(self):
        cfg = CFG.get("display") or {}
        self.address = cfg.get("i2c_address")
        self.screen = Screen(cfg)
        self.dev = None
        self.shadow = None  # the panel's memory as we last wrote it; None when we cannot know
        self.full_at = self.checked = float("-inf")
        self.problem = None
        self.held = False
        self.lock = threading.Lock()  # guards the screen
        self.wake = threading.Event()
        self.tally = {"at": time.monotonic(), "frames": 0, "bytes": 0, "send_s": 0.0, "cpu_s": 0.0}
        if self.address is not None:
            threading.Thread(target=self.run, daemon=True).start()

    def tell(self, what, *args):
        """From the other threads: something the screen should know (on_gesture, on_say, on_eyes, on_sense,
        release). It answers False when nothing changed."""
        with self.lock:
            changed = getattr(self.screen, what)(time.monotonic(), *args)
        if changed is not False:
            self.wake.set()

    def online(self, online):
        with self.lock:
            self.screen.online = online
        self.wake.set()

    def dark(self):
        """True when the panel is switched off. It forgets its setup on a power dip, and any other program that
        drew on it switches it off on the way out, while our frames keep landing in its memory unseen. Bit 6 of
        the SSD1306 status byte is "display off"."""
        from smbus2 import SMBus
        with SMBus(1) as bus:
            return bool(bus.read_byte(self.address) & 0x40)

    def run(self):
        while True:
            wait = HEAL_EVERY_S
            try:
                wait = self.frame(time.monotonic())
                self.problem = None
            except Exception as e:
                if str(e) != self.problem:  # once per problem, not once per frame
                    print(f"[servod] display: {e}")
                self.problem = str(e)
                self.dev = None
            self.wake.wait(wait)
            self.wake.clear()

    def frame(self, now):
        """Draw what changed. Returns how long the picture will keep without being asked again."""
        from luma.core.interface.serial import i2c
        from luma.oled.device import ssd1306
        from PIL import Image, ImageDraw
        import oled
        cpu = time.thread_time()
        check = now - self.checked >= HEAL_EVERY_S
        if check:
            self.checked = now
        if self.dev is None or (check and self.dark()):
            self.dev = ssd1306(i2c(port=1, address=self.address))  # the full setup, which switches it on
            self.shadow = None
            print("[servod] display on")
        # A frame can hold the I2C bus for longer than a servo step lasts, so during a move on real servos
        # the eyes jump to where they were heading and keep still.
        moving = bool(servos.kit) and servos.moving.is_set()
        if moving and self.held:
            return 0.25
        self.held = moving
        img = Image.new("1", (128, 64))
        with self.lock:
            (self.screen.settle if moving else self.screen.update)(now)
            self.screen.draw(ImageDraw.Draw(img))
            fps = FPS_CAP if self.screen.animating(now, sweat=False) else SWEAT_FPS if self.screen.animating(now) else 0
            due = self.screen.next_event(now)
        pages = oled.pack(img)
        if self.shadow is None or now - self.full_at >= FULL_EVERY_S or STATS == "full":
            self.shadow, self.full_at = None, now
        started = time.monotonic()
        sent = oled.send(self.dev, pages, oled.diff(self.shadow, pages))
        send_s = time.monotonic() - started
        self.shadow = pages
        if STATS:
            self.count(now, sent, send_s, time.thread_time() - cpu)
        if moving:
            return 0.25
        if fps:  # leave the bus free a third of the time, whatever its speed
            wait = max(0.005, max(1 / fps, 1.5 * send_s) - (time.monotonic() - now))
            return wait if due is None else min(wait, max(0.0, due - now))
        return HEAL_EVERY_S if due is None else min(HEAL_EVERY_S, max(0.0, due - now))

    def snapshot(self, *_):
        """On SIGUSR1: save what the panel was last sent as ~/peak/oled.png. The panel cannot be read back,
        so this is the nearest thing to seeing the glass from another machine."""
        try:
            import oled
            oled.unpack(self.shadow).save(HERE.parent / "oled.png")
        except Exception as e:
            print(f"[servod] snapshot: {e}")

    def count(self, now, sent, send_s, cpu_s):
        t = self.tally
        t["frames"] += 1
        t["bytes"] += sent
        t["send_s"] += send_s
        t["cpu_s"] += cpu_s
        if now - t["at"] >= STATS_EVERY_S:
            print(f"[servod] face: {t['frames']} frames, {t['bytes']} bytes, {t['send_s']:.2f} s sending, "
                  f"{t['cpu_s']:.2f} s cpu in {now - t['at']:.0f} s")
            self.tally = {"at": now, "frames": 0, "bytes": 0, "send_s": 0.0, "cpu_s": 0.0}

display = Display()
signal.signal(signal.SIGUSR1, display.snapshot)

# ---------- speech ----------
MAX_SAY_CHARS = 200  # matches contracts/cmd.schema.json

def speak(text):
    """Placeholder until Piper audio lands. Text goes to espeak-ng as one argv entry, never through a shell."""
    text = text[:MAX_SAY_CHARS].lstrip("-")  # a leading '-' would be read as an option
    if not text.strip():
        return
    if SIM:
        print(f"[sim] say: {text}")
        return
    subprocess.Popen(["espeak-ng", "--", text], stdout=subprocess.DEVNULL, stderr=subprocess.DEVNULL)

# ---------- dead-man switch ----------
deadman = DeadMan()  # touched only from paho's thread (the callbacks below)

def hold(why):
    """Nobody can stop the body any more (deadman.py): cancel the move and the waiting one, keep the servos where
    they are, give the eyes back to the reflexes. One line, so the log shows every hold and its cause."""
    was_moving = servos.moving.is_set()
    cancel_motion()
    display.tell("release")
    pos = ", ".join(f"{n} {d:.0f}" for n, d in servos.pos.items())
    print(f"[servod] deadman: hold ({why}){'; move cancelled' if was_moving else ''}; servos held at {pos}")

# ---------- mqtt ----------
def on_connect(c, u, flags, rc, props=None):
    if rc.is_failure:
        print(f"[servod] broker refused: {rc}")
        return
    print(f"[servod] connected to {BROKER} as {NODE}")
    deadman.on_broker(True)
    c.subscribe([(f"peak/{NODE}/cmd", 0), (MIND_STATUS_TOPIC, 0)])
    c.publish(STATUS_TOPIC, "online", retain=True)
    display.online(deadman.alive)

def on_disconnect(c, u, flags, rc, props=None):
    why = deadman.on_broker(False)
    print(f"[servod] disconnected from {BROKER}: {rc}")
    if why:
        hold(why)
    display.online(False)

def on_mind_status(payload):
    was = deadman.alive
    why = deadman.on_mind_status(payload)
    if why:
        hold(why)
    elif deadman.alive and not was:
        print("[servod] deadman: mind online, commands run again")
    display.online(deadman.alive)

def on_message(c, u, msg):
    """Every command is checked (cmdcheck.py) and a bad one dropped with one line. Nothing raised here may reach
    paho: an exception out of a callback would end its network loop, and the body would stop listening."""
    if msg.topic == MIND_STATUS_TOPIC:
        try:
            on_mind_status(msg.payload)
        except Exception as e:
            print(f"[servod] mind status failed on {msg.payload[:40]!r}: {e!r}")
        return
    try:
        cmd = json.loads(msg.payload)
    except Exception:
        cmd = None
    problem = validate_cmd(cmd, CFG["servos"], GESTURES)
    if problem:
        print(f"[servod] dropped {msg.payload[:120]!r}: {problem}")
        return
    try:
        run_cmd(cmd)
    except Exception as e:
        print(f"[servod] command failed on {msg.payload[:120]!r}: {e!r}")

def run_cmd(cmd):
    if cmd.get("stop"):
        # Drop anything waiting, abort what is running, then go limp (Stage B: stop will hold, release go limp).
        # Speech is left alone.
        cancel_motion()
        servos.release()
        display.tell("release")
    elif "say" in cmd:
        speak(str(cmd["say"]))  # independent of motion, so a line is never held up by a wave
        display.tell("on_say", str(cmd["say"])[:MAX_SAY_CHARS])
    elif "eyes" in cmd:
        display.tell("on_eyes", cmd["eyes"])
    elif "gesture" in cmd or "servo" in cmd:
        enqueue_motion(cmd)
        if "gesture" in cmd:
            display.tell("on_gesture", str(cmd["gesture"]))

client = mqtt.Client(mqtt.CallbackAPIVersion.VERSION2, client_id=f"peak-{NODE}")
client.will_set(STATUS_TOPIC, "offline", retain=True)
# the broker user (docs/broker.md), from ~/peak/peak.env through the unit's EnvironmentFile. No password, no login.
if os.environ.get("PEAK_MQTT_PASSWORD"):
    client.username_pw_set(os.environ.get("PEAK_MQTT_USER") or NODE, os.environ["PEAK_MQTT_PASSWORD"])
client.on_connect = on_connect
client.on_disconnect = on_disconnect
client.on_message = on_message
client.connect(BROKER, BROKER_PORT, KEEPALIVE_S)
client.loop_start()

try:
    while True:
        sense = read_sense()
        display.tell("on_sense", sense)
        client.publish(f"peak/{NODE}/sense", json.dumps(sense))
        time.sleep(CFG.get("sense_interval_s", 5))
except KeyboardInterrupt:
    pass
finally:
    client.publish(STATUS_TOPIC, "offline", retain=True)
    client.disconnect()
