prbstr/peak/(commit log)

2026-11-02 Initial commit: peak hive-mind robot
    One mind on the Mac, many Lego bodies over MQTT. First body is a Technic
    mech suit driven by a Raspberry Pi 3B.
    - mind/: Node orchestrator. MQTT events go to a local Ollama model
    (default richardyoung/qwen3-14b-abliterated:q4_K_M), which replies in a
    structured JSON shape that becomes gesture and say commands.
    - node/: Python servo daemon for the Pi (PCA9685, eased and clamped moves,
    named gestures, simulation mode). Speech goes to espeak-ng as an argument
    list, never through a shell.
    - contracts/: JSON schemas for the MQTT topics.
    - scripts/ and Makefile: Pi first-boot setup, rsync deploy, Mac helpers.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
2026-11-02 Remove embedded aedes broker in favour of Mosquitto
    Mosquitto is the single broker (retained messages, Last Will, native
    ESP32 support), so mind/broker.js and the aedes dependency are dead weight.
2026-11-02 Add hearing and vision senses
    hearing.js records mic chunks, skips silence, transcribes with whisper and
    publishes heard events. vision.js watches the camera stream, describes the
    scene with an Ollama vision model when it changes and publishes see events.
    The orchestrator now drops events when two are already queued.
2026-11-02 Stream the Pi microphone to the mind
    node/audiod.sh sends the Pi USB mic to the Mac as raw PCM over UDP.
    hearing.js can read that stream (PEAK_AUDIO_SOURCE) and now records in
    continuous segments instead of reopening the device per chunk. Whisper gets
    a hint so it hears "Peak" correctly.
2026-11-02 hearing: allow trailing punctuation in hallucination filter, raise silence cutoff
    The Pi USB mic idles around -36 dB, so the -45 dB default let every quiet
    chunk reach whisper, which answered with 'Thanks for watching.' and kept the
    brain busy.
2026-11-02 Update shopping list: orders and power layout
2026-11-02 CLAUDE.md: record power options, roadmap stages and remaining purchases
2026-11-02 CLAUDE.md: Pi first boot done, note ServoKit import problem
2026-11-02 Drive the PCA9685 directly over smbus2 instead of ServoKit
    adafruit_servokit needs Blinka's PWM library, which does not build on a Pi 3B.
    node/pca9685.py writes the registers itself, with unit tests on a fake bus.
2026-11-02 Harden the body: stop command, motion queue, presence, eased boot
    servod: one-deep motion queue where a newer command replaces the waiting one,
    speech no longer blocked behind gestures, {"stop":true} aborts and releases all
    servos, servos ease to rest one at a time on boot instead of snapping together,
    and a retained status topic with a Last Will tells the mind which bodies are up.
    mind: latest event wins instead of dropping the newest when busy; offline
    bodies leave the hive map.
    The systemd unit pointed at a broker IP on the wrong subnet; it now uses the
    Mac's mDNS name.
    [servod.py]
2026-11-02 CLAUDE.md: cable swap fixed idle undervoltage, load still dips
2026-11-02 CLAUDE.md: real-load power result, hearing quality and wake-phrase bug
2026-11-02 audiod: force mono on the output side
    ALSA ignored -ac 1 as an input option and ffmpeg streamed stereo. hearing.js
    read it as mono, so whisper heard half-speed interleaved samples: every live
    transcript was garbage while direct arecord clips were perfect.
2026-11-02 whisper-server: medium.en by default, drop the --prompt
    The prompt made whisper treat 'Hey Peak' as already said and cut it off the
    front of utterances. medium.en costs about 0.5 s per utterance on the M4 Pro.
2026-11-02 Brain: shared prompt core, gesture descriptions, timing, and a bake-off harness
    The brain answered "wave at me" with look_right. The prompt listed gesture names
    with no meaning, no examples, and sent the full hive sense payload every turn.
    - orchestrator/brain.js: buildMessages/askBrain/parseReply, system prompt with
    one line per gesture and six examples, say capped at 200 like the Pi,
    temperature 0.3, hive summary is just the online body names.
    - orchestrator/gestures.js: names from node/gestures.yaml, descriptions in the
    mind (servod iterates the YAML values as keyframes, so no describe: key there).
    - lib/ollama.js: one client for brain, vision and bake-off; same load-time
    options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
2026-11-03 Brain: System One lessons, prompt tuned to 100% strict, gesture fires from the streamed reply
    Lessons from TypeSafe's Jev written up in mind/orchestrator/LESSONS.md and
    applied: eight narrow rules and one more example in the prompt, tuned one
    failure at a time with held-out case groups (25 written before tuning, 22
    after), take Qwen3-VL from 94% to 100% strict on 97 steps and 95% on the
    cases written afterwards. The orchestrator now streams the reply and sends
    the gesture when its field closes (0.24 s) instead of after the spoken line
    (0.4 s); 0 mismatches in 485 calls. Confidence from logprobs is logged;
    PEAK_MIN_CONFIDENCE vetoes on it, off by default because Qwen3-VL is as
    sure when wrong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
2026-11-05 Pi sends real data: sensors in the sense message, camera into vision
    servod reads the HC-SR04+ and PIR from config.yaml and adds distance_cm,
    motion and the throttled power flags to peak/<node>/sense, now every
    second. PEAK_SIM=1 simulates only the servos, so a body with no PCA9685
    still senses.
    camd.sh never ran: an apostrophe in its error text broke the script.
    Fixed, plus a keyframe every second and no per-frame logging. vision.js
    tells ffmpeg the UDP stream is bare H264 with a short probe, which cuts
    a look from 5 s to 2 s.
    Checked live on 5 Nov 2026: sense arrives on the Mac each second, two
    camera frames were described and answered by the brain, and a faked
    heard event produced the w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
    [servod.py]
2026-11-05 CLAUDE.md: owner's handover folded in, PIR confirmed live
    The owner pasted the handover kept in their claude.ai Project. Checked
    its fix list against the Pi, recorded the header pin map and the planned
    fan, vibrator and NeoPixel pins, and noted where it disagrees with this
    file on what has been ordered. The PIR reads true in the sense stream.
2026-11-05 CLAUDE.md: owner confirmed servos and PCA9685 are ordered
2026-11-05 Brain wired to the parts: sensed events in, replies on the OLED
    In: mind/senses/presence.js turns the body's sense readings into
    {"sensed": ...} events on two moments, movement after a quiet minute
    and something coming close in front, relative to what is usually
    there. The brain prompt explains the event and answers it with one
    line and no gesture; untuned, it waved at something 3 cm away.
    Out: servod draws each gesture and spoken line on the SSD1306 OLED.
    Sense readings now go out every 0.5 s, with the power flags cached.
    Bake-off: new groups sense, sense2 (held out), quiet (held out, real
    camera descriptions) and two sequences; cases can require silence.
    Final prompt is 100% on every gro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
2026-11-05 servod: bring a dark OLED back on
    The owner saw nothing on the OLED while servod logged no errors: the
    panel was switched off (status byte 0x42) and frames were landing in
    its memory unseen. A power dip resets the panel, and any other luma
    program switches it off as it exits. servod now checks the status
    byte before each draw and every 5 s, and redoes the setup when the
    panel is dark or was replugged.
    Tested by switching the panel off from a second program: back on
    within 7 s.
    [servod.py]
2026-11-05 Pi power measured with the mic: undervoltage in every state
    node/powerwatch.sh samples the firmware power flags twice a second.
    With the USB mic plugged in: camera on, camera plus mic stream, and
    mic stream alone were each under voltage in every sample; with both
    stopped, 50 of 57. No reboot in four minutes and the audio reached
    the Mac, but the supply holds neither load.
2026-11-05 The character is now Rho
    Wake word, brain identity, prompt examples and every bake-off case
    that named Peak. The project, topics and PEAK_ settings keep their
    name.
    Rho sounds like row and roe, and whisper wrote a bare "Rho" as
    "Roll.". The gate wakes on "rho" anywhere and on the homophones only
    where a name stands: opening the utterance or closing it after a
    comma, set off by punctuation. Peak and its spellings no longer wake
    it.
    Bake-off unchanged: 100% on every group but the one old miss, 143
    steps x 3 runs. The new wake word is not yet tested with a voice.
2026-11-05 Face: the OLED shows a Doom-style face that reacts on the body
    servod now draws node/screen.py's picture. Idle it is a status bar:
    distance, a 24x29 pixel face drawn double size, and HP from the Pi's
    power flags. The face glances about, follows look gestures, grins at
    other gestures, moves its mouth while a line is spoken, winces when
    something comes within 30 cm and dies when the broker is gone. A reply
    moves the face aside for the gesture and the line, paged, then the
    status bar returns.
    All of it is decided on the Pi with no change to the mind or the
    contracts. On real servos the face holds still during a move, since a
    frame holds the I2C bus longer than a servo step.
    screen_preview.py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
    [screen.py, servod.py, test_screen.py]
2026-11-05 Eyes: the OLED shows a Python port of FluxGarage RoboEyes; repo is GPL-3
    node/eyes.py ports RoboEyes V 1.1.1 (GPL-3-or-later, (C) 2024-2025
    Dennis Hoelscher): rounded-rectangle eyes with moods, nine positions,
    blinking, wandering, laughing, confusion and sweat. Tweens are eased by
    elapsed time instead of halved once a frame, so the motion keeps its
    speed at the frame rate an I2C OLED on a Pi gets.
    node/screen.py moves the eyes by reflex, from what the body knows:
    asleep when the broker is gone, startled when something comes close,
    held to the side by a look gesture, pulsing while a line is spoken,
    tired and sweating as the Pi's power gets worse, otherwise wandering.
    The Doom-style head and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
    [eyes.py, eyes_preview.py, oled.py, screen.py, servod.py, test_eyes.py, test_oled.py]
2026-11-05 Bake-off: cases for the brain picking a trick, written before the prompt
    A case can now say which tricks the eyes may show ("eyes": [names or
    null]); it counts toward strict where present. Cases that say nothing
    about eyes are counted when the brain moves them anyway, to catch
    over-acting.
    44 cases and a 5-step sequence. Tuning groups: eyes, trick. Held out:
    eyes2, trick2, eyesneg ("don't look angry"), cross (a gesture and an
    expression together; look left keeps the eyes out of it).
2026-11-05 Brain: an eyes field so it can pick a trick, switched off by default
    With PEAK_BRAIN_EYES=1 the reply shape is {gesture, eyes, say}: eyes
    names a trick from tricks.yaml or is null, gesture stays first so it
    still fires early. The orchestrator plays the trick after the reply,
    detached; the reply's own gesture and line win over the trick's, a
    sensed event drops a trick's gesture, and a {"stop": true} on the cmd
    topic drops the trick in flight.
    Bake-off, 192 steps x 3 runs: the eyes were right 147 of 147 times in
    both prompt versions, held-out groups included, at about 110 ms more
    per reply. But each version cost one old case (v1 the wave on "night
    night", v2 a wave at "what are you"), and the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
2026-11-05 Bake-off: a third eyes prompt, and what each example was doing
    v3 is v1 plus only a goodnight example. It brings back the wave on
    "night night" and leaves "Look surprised" alone, so that miss in v2
    came from the point-and-surprised example. But "Rho, what are you?"
    still waves 3 of 3: that one is the goodnight example, whose gesture
    is a wave. Eyes right 147 of 147 again.
    Three versions, each one old case short of the gate. The code stays
    at v1 with the field off; turning it on is the owner's call.
2026-11-07 Pi power: the owner's new supply passes the bench test
    After a reboot: throttled=0x0, 1200 MHz. With servod, camera, mic, a wave
    and an eyes trick running: 0 undervoltage samples in 58 over 30 s, no
    kernel dips, CPU 700-1200 MHz, 47 °C. Next step 1 closed; the supply's
    model is still to be noted.
2026-11-07 Pi power: the supply is the official 5.1 V 2.5 A micro-USB one
2026-11-07 CLAUDE.md: desk light plan settled; guide with wiring drawing linked
    The ESP32-C3 and nRF24L01+ are on the desk; lightbar2mqtt is the firmware,
    used unchanged, with the puck's serial borrowed. Every device becomes a hive
    node declared in mind/devices/devices.yaml.
2026-11-07 Devices: the desk light as a hive node the brain can switch
    devices/devices.yaml declares a device's topics and the actions the brain may
    ask for, each with the payload to send; devices.js checks it the way tricks.js
    checks tricks and publishes. The brain reply gains an action field behind
    PEAK_BRAIN_DEVICES (off until the bake-off says the old groups hold), a trick
    may carry an action step, and npm run device plays one by hand. 28 cases and
    one sequence for the light are written before tuning: dev tunes, dev2, devneg
    and devcross are held out.
2026-11-07 Action prompt v2, bake-off and live check; desk-light firmware notes
    The brain's action field: v1 left every old group equal or better than the
    eyes-v1 baseline; v2 adds a question example and scores 99% strict, 96 of 99
    actions right, 0 unasked switches in 486 old calls, 72% on the 12 fresh cases
    written afterwards. Switch stays off in code. End to end over MQTT with faked
    events: the right payload on the light's topic 0.6-1.0 s after each.
    devices/desk-light holds the config.h template and the flash steps; the clone
    and config.h are gitignored.
2026-11-07 Desk light: real root topic and puck serial; flash notes from the first live run
    The ESP32-C3 SuperMini joined Wi-Fi only with TX power at 8.5 dBm and shows
    serial output only when built with CDCOnBoot=cdc. The puck is 0x08D722.
2026-11-07 Desk light lit by voice; channel hopping and a persistent QoS 1 link
    Sent on channel 68 alone the bar switched off but never on; the burst now hops
    over the puck's four channels. The radio burst at full power knocked the C3
    off the broker and a voice window's commands were lost, so: low radio power,
    no modem sleep, a persistent session with QoS 1 on both ends. Results and the
    new traps in docs/log.md, CLAUDE.md and devices/desk-light/README.md.
2026-11-07 Desk light on the glass: full radio power kept, on/off memory from the broker
    Lower radio power lost the off-to-on toggle and the level pairs; the Wi-Fi
    is protected by no modem sleep and the persistent QoS 1 session instead.
    The firmware reads its retained state back at connect instead of assuming
    ON at boot, and the level actions switch the bar on as well.
2026-11-07 Desk light: no queue for an offline device; the firmware heartbeats online
    The persistent QoS 1 session replayed queued on/off commands minutes late,
    each a real toggle of the bar. Back to a clean session and QoS 0; the mind
    refuses to publish to a device that is offline and logs it. The firmware
    republishes online every 10 s because the broker's will for the old session
    overwrote the new birth after every reconnect. Tests no longer depend on
    the device switch in .env.
2026-11-07 up.sh: judge the Pi daemons by pid files, not pgrep
    The pgrep guard matched its own ssh command line, which names servod.py,
    so a dead servod was never restarted and a live camera got a duplicate.
    camd and audiod now leave pid files too. Tested: a second run starts nothing.
2026-11-07 Desk light on ESPHome: the xiaomi_lightbar component on the ESP32-C6
    The owner's pick after a day on lightbar2mqtt: relative steps, state kept
    across reboots, the puck heard, ESPHome's own MQTT with birth and will. On
    the glass by hand and by voice. devices.yaml speaks ESPHome's light JSON;
    "bro" joins the wake homophones at the owner's word; the C6 node template
    becomes devices/blank-node for the spare C3.
2026-11-07 Desk camera bake-off: hand tracker gate and hand crops on real overhead recordings
2026-11-07 CLAUDE.md: desk camera state and next step
2026-11-07 Desk camera: hand-tracked crops become quiet doing events the brain uses when spoken to
    vision.js desk mode (default): hands.py keeps one ffmpeg on the 1080p stream, runs MediaPipe
    hands at 5 fps and crops around the hands; each crop is described and published as
    {"doing"}. A heard event cancels the look in flight and pauses looking for 8 s.
    The orchestrator stores doing per node and adds it to the next heard event while under
    30 s old; every other prompt is byte-identical. camd.sh defaults to 1920x1080 from the
    2304:1296 sensor mode. Brain bake-off: 8 new desk cases 24/24, older groups as before.
2026-11-07 Desk camera: measure the brain queueing behind looks; parallel slots do not apply to qwen3vl
2026-11-07 Desk camera: a 4B vision model beside the brain keeps replies fast; scored against 8B, 2B
2026-11-08 Desk rig: printed carrier for the monitor arm, camera plumb, sonar height, Rho's perch, mic bar
    Research and design pass (arm, boards, sonar physics, mic, brick-compatible printing, rig patterns;
    three designs, two judges, a critic), then one parametric OpenSCAD file: a carrier that leans 30 deg so
    the shelf is level while the arm's head rests on its face-down stop, a flat pod under it for the camera,
    GY-521 and a vial, the HC-SR04+ on an outrigger on an 8 mm grid, Rho on a glued real 4x8 plate, the mic
    in a ring on a bar, two horns to lift by. STLs, renders and a ballast DXF committed. Nothing printed yet;
    the measure-first list is in hardware/desk-rig/README.md. The log has the numbers and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
    [ballast.dxf, carrier.stl, coupon.stl, micbar.stl, outrigger.stl, pirwedge.stl, pod.stl, rig.scad]
2026-11-08 Session 1 of the merged review plan: a perf line, the history-trim cache fix, vision on the 4B
    - The mind logs one [perf] line per reply (wire, queue, gesture, brain, prompt eval, whether the cached
    prefix was kept); npm run perf turns them into p50/p95 per stage.
    - trimHistory cuts back to 10 messages once past 20 instead of one turn per event. A moved first turn made
    llama-server re-read the whole history: gesture 2.0 s against 0.32 s, measured live on 20 and 24 events.
    - Events carry `at` (contracts/event.schema.json); the mind strips it before the brain, so the prompt is
    unchanged. presence.js now publishes through publishEvent.
    - Vision describes on qwen3-vl:4b-instruct by default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
2026-11-08 Lane A: launchd supervision, appended logs, Last Wills and health for the Mac parts; systemd units for the Pi
    - mind/launchd/peak.<part>.plist.template for whisper, mind, hearing, vision, presence, voice, health:
    KeepAlive on unsuccessful exit, ThrottleInterval 10, logs appended to ~/Library/Logs/peak/<part>.log
    - scripts/run-part.sh loads .env and execs the part; install-agents.sh renders the plists (--dry-run,
    --uninstall, --selftest, --newsyslog); up/down/status become launchd and MQTT-status wrappers
    - connect(part) sets a retained Last Will on peak/mind/<part>/status and retries the broker 1-30 s;
    homepod.py the same; vision restarts hands.py up to 3 times a minute
    - orchestrator/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
2026-11-08 Safety rails in code: event age, actions only from speech, no gesture for sensed, servod command check
    Lane B of the merged review plan (ARCH P1, P2, P8; P7 and the worker's stop race written down for Stage B).
    Mind: orchestrator/policy.js drops an event older than PEAK_EVENT_MAX_AGE_MS (5000) on receipt and as it
    leaves the queue (no `at` counts as fresh), allows a device action only for a heard event answered within
    PEAK_ACTION_MAX_AGE_MS (8000), a trick's action step included, and vetoes a gesture for a sensed event on the
    early streamed path as well as the parsed one. Each veto logs `[mind] veto ...`. `doing` is cut to 200 chars.
    The prompt and brain.js are untouched; the bake-off is id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
2026-11-08 CLAUDE.md after merging lanes A and B: rails, servod check, test counts, next steps
2026-11-08 Mac side of Rho cut over to launchd; rails live; kill and stale-event checks logged
2026-11-08 Pi on systemd units with servod's command check; newsyslog and lupin permissions done
2026-11-08 The mind logs each reply in one line, so a silent device switch leaves a trace
2026-11-08 Spoken window on the new setup: five requests heard and answered, light switched; logged
2026-11-08 Broker logins: every client can log in, users and an ACL per role, an on/off switch; broker still anonymous
    Tested on private brokers: refused without a login, each role held to its topics, run-part and Python log in.
    The owner writes the passwords with scripts/broker-passwords.sh; docs/broker.md has the order.
    [servod.py]
2026-11-08 Voice: Kokoro on the Mac speaker beside the HomePod, first sound 0.21 s live
    mind/voice/local.py speaks peak/+/cmd lines with Kokoro 82M (mlx-audio) on the Mac's default output: one piece
    per sentence, a long first sentence cut once, Kokoro's silent pads trimmed, one-deep newest-wins queue, retained
    peak/mind/speaking, Last Will and exit lines as homepod.py, PEAK_MQTT_USER/PASSWORD when set.
    PEAK_VOICE_BACKEND=kokoro|homepod (default homepod) picks it in npm run voice. kokoro_bench.py measures it.
    Bench: first sound 0.14 s p50, 0.27 s max (gate 0.5 s), RTF 0.08, 313 MB on the GPU. Live on a private broker:
    20 lines p50 0.21 s, p90 0.44 s; slower (0.4-0.8 s, once 2.0 s) while Ollama's 4B des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
2026-11-08 Rho speaks on the Mac speaker: the voice agent follows PEAK_VOICE_BACKEND, Kokoro switched on, first sound 0.12-0.14 s live
2026-11-08 Spoken window on the Kokoro voice: five utterances answered in 0.69-0.72 s, servod restarted on the new talk delay
2026-11-08 Fast lane: exact spoken commands act in 1 ms without the brain, and a spoken stop halts the body and drops the reply being thought
    The bake-off loads heldout/*.json, prints tuned and held-out strict apart with the gates, and --fastlane scores the
    lane as the mind runs it: 147 of 147 lane answers right, tuned groups unchanged (the same four misses as run 4),
    held1 92% with the brain alone and 93% with the lane. lib/ollama.js takes a host per call and PEAK_BRAIN_HOST, unset.
2026-11-08 The brain on its own Ollama: gesture p95 0.53 s under load against 20 s shared, no reloads; held1 and fast lane logged
    sh.peak.ollama-brain runs Homebrew's ollama on 127.0.0.1:11435 with one slot and keep-alive -1; the mind reaches it
    through PEAK_BRAIN_HOST and pins the brain there. health probes it. The full bake-off on it matches run 4.
2026-11-08 Stop window: "Bro stop" cut the voice 4 ms after hearing; Rho answered its own voice inside the attention window
2026-11-09 Dead-man switch in servod: the mind's Last Will or a lost broker cancels the move and holds the servos
    node/deadman.py decides; servod cancels the running and waiting move, keeps the servos where they are (no
    release: a limp arm drops), shuts the eyes and logs one line. No silence timer, since one legal move lasts 5 s.
    Keepalive 60 s to 5 s. A cancel count on each queued move closes the stop race of 8 Nov.
    Live on the Pi 9 Nov 06:59: kill -9 of the mind 1.5 s into a 5 s head move held it at 108 of 170 degrees and the
    queued wave never started; a broker restart mid-move held the waist the same way.
    [deadman.py, servod.py, test_deadman.py]
2026-11-09 CLAUDE.md: the echo-cancelling mic to buy, reSpeaker XVF3800 with case and Seeed's 4R 5W speaker
2026-11-09 Runbook: back from a power cut, a wiped Mac or a dead SD card, and what is not in git; pi-firstboot.sh matches the Pi as it runs; UPS picked
2026-11-09 Hearing: up to three utterances wait for whisper, short ones first, the longest dropped when full
    Fix brief 9 Nov, item 3 (ARCH B3). Before, one waiting slot held the newest utterance, so Rho's echo could replace a
    waiting "stop" before whisper heard it. senses/utteranceQueue.js is a pure push/next: MAX_WAITING 3, utterances of
    1.5 s or less (a spoken stop) taken first, then first come first served; when a fourth arrives the longest of the
    four goes, so a short one is never dropped while a long one waits. Nothing is dropped for age before transcription.
    Each drop logs its length and what is still waiting. hearing.js drains the queue in one pump loop instead of
    re-entering handle(). Test: fiv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
2026-11-09 Log: the stop fixes live, 9 Nov 19:39-19:43: 5 of 5 stops and "wait, stop" cut a story, "bus stop" and "is that enough" did not
2026-11-09 Reviews and briefs of 9 Nov, the 7 Nov Communica in-store purchases in SHOPPING.md, the desk-light cart brief, the desk camera mockup, the light's ESPHome .gitignore
